notazizelse/Orbita26/project_report (1).pdf

### The report for this stage must include the following information:

1 . | Team Name | Team "BioBox" The name reflects our core idea: a simple, smart container for biological experiments in space.
2 . | Team Composition and Roles | • Alex (Team Leader & Engineer): Responsible for the mechanical design of the sealed capsule and 3D modeling. • Maria (Biologist): Responsible for choosing the biological samples and preparing the experiment conditions. • Ivan (Electronics Specialist): Responsible for sensors, temperature control, and the heating system.
3 . | Mission Objective of Your Spacecraft | Core Purpose: To test a low-cost, unified stratospheric capsule that can keep living biological samples safe by maintaining stable internal pressure and Earth-like temperature. Proposed Experiment: We plan to launch micro-greens or bacteria samples into the stratosphere. The goal is to check if our smart enclosure can completely shield them from freezing temperatures (down to -70°C) and near-vacuum conditions.
