notazizelse/Orbita26/ClearView — presentation (EN).pdf

Orbita International Space Tournament
- 2026

# ClearView

## A spacesuit visor wiper with a self-cleaning edge

### International House Tashkent Lyceum

Lola Anvarjonovna Sultonova, Grade 11

Supervisor: Ezoza Nodirjon qizi Yuldosheva

Section 2 · Crewed Spaceflight · Tashkent Visualization of the model, not a photo

Apollo 17 · December 1972

# “I think dust is probably one of

# the greatest inhibitors to a

nominal operation on the Moon.

### Gene Cernan, commander of Apollo 17

Post-flight technical debriefing, 1973 | Cernan in the lunar module after a moonwalk: the suit is grey with dust. Photo: NASA
ClearView · Lola Sultonova · Section 2 | 02 / 13

The problem

# Lunar dust vs. the visor

Fine | finer than a human hair, it gets into every gap
Sharp | the Moon has no wind or water, so the grains never get rounded like sand
Charged | sunlight charges the dust, and it clings to surfaces

Apollo 17: the astronauts kept wiping dust off their visors. Artemis is sending people back to the Moon, and the dust is still there.

Earth sand: rounded | Lunar dust: sharp

Particle shapes under magnification. The sharp edges are what scratch the visor.

Existing solutions

# What has been tried

## Apollo brushes

used on the Moon

+ simple, no electronics

− scratch the visor and clog with dust

## NASA brush study

lab tests, 2011

+ the best brushes removed over 90% of the dust

− tested on radiator surfaces, not visors

## NASA dust shield

electrodynamic

+ an electric field pushes dust off without touching

− complex electronics, high voltage

The gap I could not find a comparison of wiper materials made for a visor, judged by transparency and scratches

Goal and hypothesis

# What I want to test

## Goal

### Find out on a model whether an edge that cleans itself keeps the visor clear over many wipes without damaging it, and pick

the best of three materials.

## Hypothesis

### An edge that gets scraped clean keeps the visor clear longer than one that does not, and soft silicone scratches

less than a stiff brush.

01

Study the dust problem and what has been tried

02

Design and 3D-print a model with two scraper-troughs

03

Test 6 variants, 18 runs in total

04

Compare the results and
recommend a material

The ClearView idea

# The edge cleans itself

A plain wiper edge clogs and smears the dust back. Here the edge gets cleaned in every cycle.

## 1 · Wipe

The edge pushes the dust across the plate.

## 2 · Scrape

It passes over a rubber strip, and the dust drops into the trough.

## 3 · Back again

The return stroke starts clean. The rest goes into the second trough.

The model

# What it is made of

1 · Tilted panel, set at 45°

2 · Acrylic plate 150×100 mm stands in for the visor

3 · MG996R servo behind the panel swings the arm ±42°

4 · Arm and holder for a brush, microfibre or silicone strip

5 · Two scraper-troughs clean the edge and catch the dust

6 · Arch over the plate

7 · BH1750 light sensor in a black housing; an LED shines from behind the panel

8 · Side supports and base

9 · Arduino Nano case

14 parts printed in PLA. The picture is a render of the print files.

Measurement

# Measuring transparency

# T = E ÷ E₀ × 100%

E is the light reaching the sensor now

E₀ is the light with a clean plate

100%

clean plate

0%

sensor covered

BH1750 sensor in a
black housing

Acrylic plate with dust

LED behind the panel

Arduino

%

Method

# How the experiment runs

Edge material | With scraper | Without scraper
Stiff brush | 3 runs | 3 runs
Microfibre | 3 runs | 3 runs
Soft silicone | 3 runs | 3 runs

6 variants × 3 runs = 18 runs. Results are averaged.

≈20 cm

45°

sieve

≈1 g of gabbro-diabase
dust per run

Readings after 1, 5, 10,
20 strokes

Dust from both troughs
weighed to 0.01 g

50 strokes for the
scratch test

Work in progress

# Progress

## Done

All 14 parts designed; every screw hole and the light path checked on the computer before printing

All 3D parts printed

Dust simulant chosen: crushed gabbro-diabase

All electronics bought: Arduino Nano, MG996R servo, BH1750 sensor, two 18650 cells with a 6 V step-down

## Next

Assemble the model

Write the Arduino code and calibrate
the sensor
Run the 18 tests and fill in the results | The printed parts, rendered from the print files

One of the printed parts: the material holder

What I will measure

# Expected results

100%

75%

50%

25%

0%
0 | 1 | 5 | 10 | 20

### The tests start once the model is assembled

## Three questions

How fast does transparency drop without the scraper?

How much does the scraper slow that down?

Which material keeps the plate
clear longest?

Solid line: with scraper. Dashed: without. Horizontal axis: number of strokes.

What the model can't show

# Limits and next steps

## Limits

Earth gravity, six times the Moon's

Air, not vacuum

Gabbro-diabase dust carries no electric charge

The plate is flat

## Next steps

A curved edge for a real helmet

A button on the glove

Pair it with NASA's dust shield

axis through the
helmet's centre

edge follows
the helmet

A helmet is part of a sphere. A curved edge turning around an axis through its centre stays pressed to the visor in every position.

# Thank you!

## Happy to take your questions

Sources

1. NASA: Scientists Developing Ways to Mitigate Dust Problem for Explorers
2. Acta Astronautica: Flexible electrodynamic dust shields for lunar missions, 2026
3. Gaier et al., Evaluation of Brushing as a Lunar Dust Mitigation Strategy, NASA, 2011
4. Kobrick et al., Three-Body Abrasion Testing Using Lunar Dust Simulants, NASA, 2010
5. Schrader et al., Modal Analyses of Lunar Regolith Simulants incl. MLS-1, NASA JSC, 2008
6. Apollo 17 Technical Crew Debriefing, NASA, 1973; quoted in Levine (ed.), The Impact of Lunar Dust on Human Exploration

[QR code: video of the
model working]

lolasultonova2008@gmail.com
