notazizelse/Orbita26/hardware/SnailPulse_revC_heartbeat_only.png

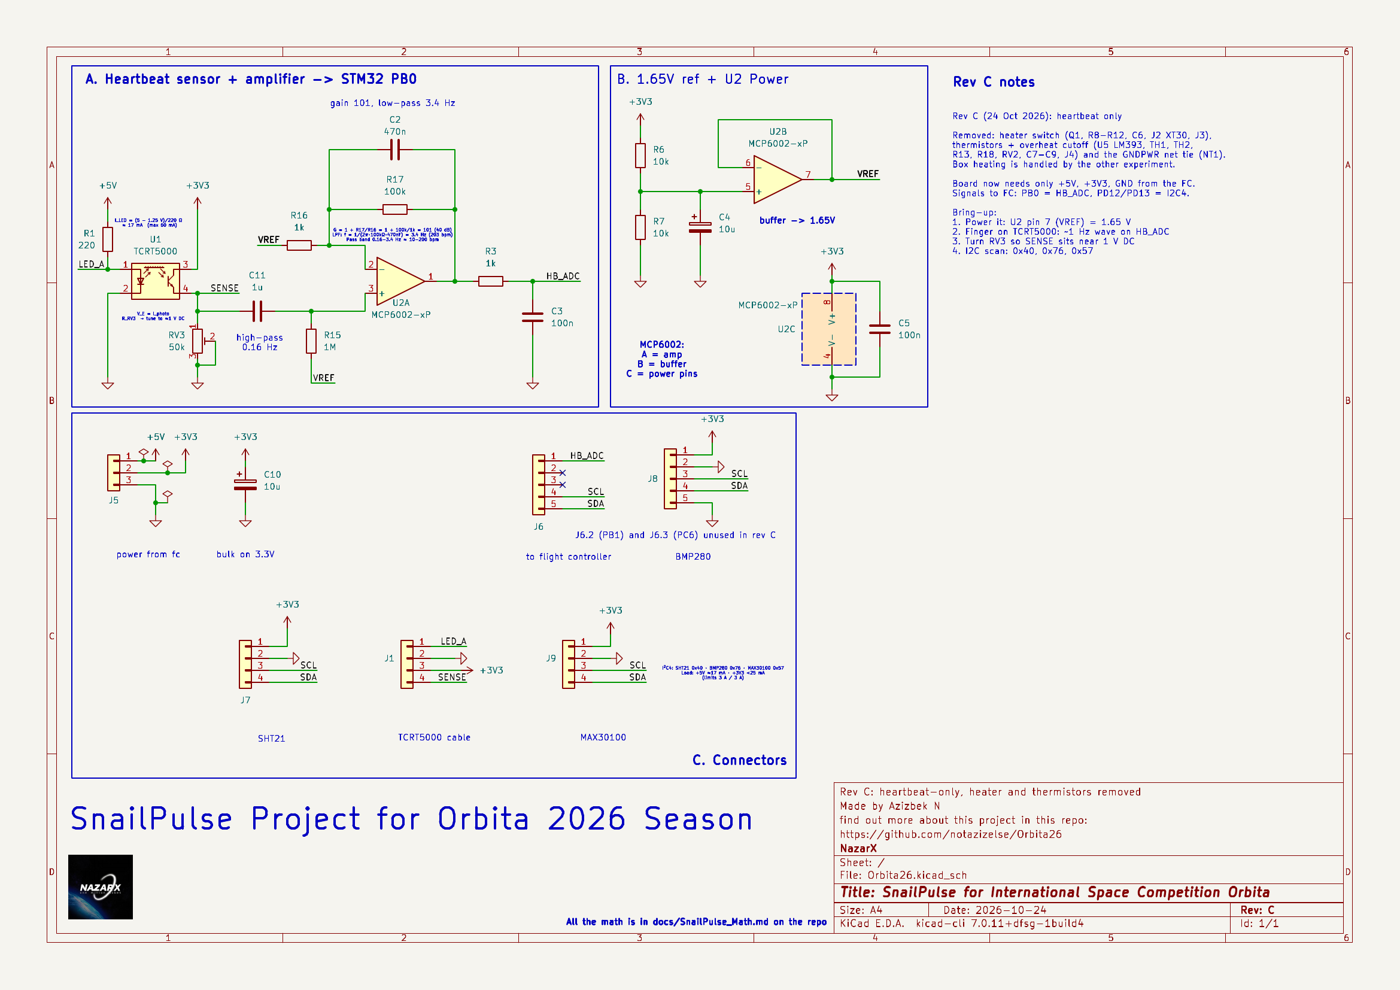
hardware/SnailPulse_revC_heartbeat_only.png
