notazizelse/Orbita26/micoair_lr900_915mhz_500mw_radio_telemetry_with_30km_range_5_550x550.jpeg

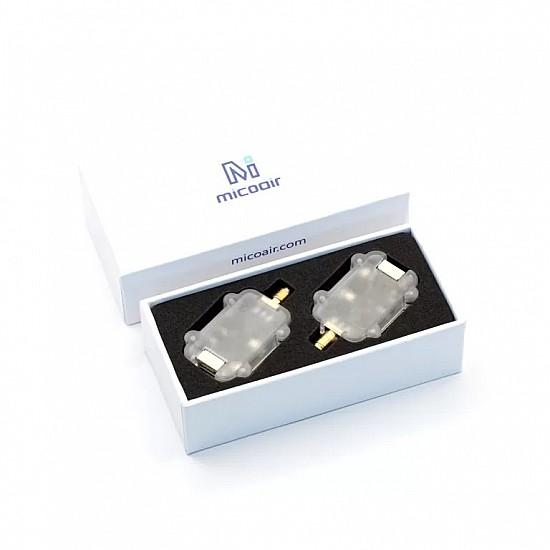
micoair_lr900_915mhz_500mw_radio_telemetry_with_30km_range_5_550x550.jpeg
