notazizelse/Orbita26/hardware/SnailPulse_shopping_list.md

# SnailPulse — список покупок, Microelectronica (electron.uz)
Цены с сайта electron.uz, 19.10.2026 ("0 сум" на сайте = уточнить у продавца).

| # | Название на сайте | Кол-во | Цена/шт | Зачем |
|---|---|---|---|---|
| 1 | FZ0225 / HW-511 Модуль датчика отслеживания линии (TCRT5000) | 2 | 8 000–13 600 | ИК-датчик сердцебиения (выпаять TCRT5000) |
| 2 | Оксиметр пульса MAX30100 | 1 | 20 000 | Запасной датчик пульса (I2C) |
| 3 | MCP6002 DIP8 | 2 | 6 800 | Усилитель + опорное 1.65 В |
| 4 | LM393N DIP8 | 2 | 3 400 | Аппаратная защита от перегрева |
| 5 | SCS-8 Dip 8pin панелька | 4 | 500 | Панельки под микросхемы |
| 6 | GY-21 SHT21 датчик влажности и температуры | 1 | 20 000 | Температура/влажность в боксе |
| 7 | Барометр BMP280 | 1 | 10 000 | Давление в боксе |
| 8 | IRLZ44N TO220 | 2 | 15 000 | Ключ нагревателя |
| 9 | 150om — 5W | 4 | ~2 000 | Нагреватель (3 шт параллельно = 50 Ом) |
| 10 | Терморезистор NTC MF58 10K | 4 | 1 000 | Температура нагревателя + защита |
| 11 | 3296W подстроечный 50KOM / 10KOM | 2 + 2 | 2 000 | Нагрузка датчика / порог защиты |
| 12 | Набор резисторов 0,25Вт 300 шт, 30 значений | 1 | 20 000 | Все резисторы (проверить 1 МОм) |
| 13 | Конденсаторы: 105-50V (1 мкФ) ×6, 474-50V (470 нФ) ×4, 104 ×10, 10mf-50V ×5 | — | 200–1 000 | Фильтры и развязка |
| 14 | 9×15 Монтажная плата 1-сторонняя | 2 | 10 000 | Плата (обрезать до 76×76 мм) |
| 15 | Набор разъёмов XH2.54 80 шт | 1 | 27 000 | Разъёмы с защёлкой |
| 16 | Клемма KF2EDG 5,08 мм (2pin ×3, 4pin ×2) | 5 | 1 000–3 000 | Питание и нагреватель |
| 17 | XT30 разъём | 1 | 5 000 | Питание 14.8 В от X8 |
| 18 | 3239 24AWG 10 м провод силиконовый | 1 | 15 000 | Монтажный провод |
| 19 | 2м кабель телефонной линии (4 жилы) | 1 | 4 000 | Кабель к датчику на раковине |
| 20 | Кембрик / термоусадка набор 100 шт | 1 | 28 000 | Изоляция |
| 21 | Каптоновый скотч 10 мм | 1 | 15 000 | Крепление NTC и проводов |
| 22 | ЦапонЛак 30 мл | 1 | 14 000 | Защита платы от конденсата |

Итого ≈ 310 000 сум.
