notazizelse/Orbita26/SnailPulse_BOM.xlsx

Orbita SnailPulse — parts list (Microelectronica, electron.uz)
Prices from electron.uz on 21 Oct 2026. Spares added for critical parts. Show the 'Name on site' column at the counter.
# | Part | Name on site | Used for | Qty | Spares | Total qty | Price each (UZS) | Line total (UZS) | Link | Note
1 | TCRT5000 sensor module (HW-511) | FZ0225 / HW-511 Модуль датчика отслеживания линии | Heartbeat sensor (desolder TCRT5000) | 1 | 2 | 3 | 8000 | 24000 | Open (https://electron.uz/product/fz0225-модуль-датчика-отслеживания-линии/)
2 | MAX30100 pulse sensor | Оксиметр пульса GY-30100 MAX30100 | Backup heartbeat sensor (I2C) | 1 | 1 | 2 | 20000 | 40000 | Open (https://electron.uz/product/оксиметр-пульса-gy-30100-max30100/)
3 | MCP6002 op-amp | MCP6002 DIP8 | Amplifier + 1.65 V reference | 1 | 2 | 3 | 6800 | 20400 | Open (https://electron.uz/product/mcp6002-dip8/)
4 | LM393N comparator | LM393N DIP8 | Hardware overheat cutoff | 1 | 2 | 3 | 3400 | 10200 | Open (https://electron.uz/product/lm393n-dip8/)
5 | DIP-8 socket | SCS-8 Dip 8pin панельки под микросхемы | Sockets so chips can be swapped | 2 | 2 | 4 | 500 | 2000 | Open (https://electron.uz/product/scs-8-dip-8pin-панельки-под-микросхемы/)
6 | SHT21 temp/humidity module | GY-21 SHT21 цифровой модуль датчика влажности и температуры | Box temperature + humidity | 1 | 1 | 2 | 20000 | 40000 | Open (https://electron.uz/product/gy-21-sht21-цифровой-модуль-датчика-влажности/)
7 | BMP280 pressure module | Барометр BMP280 (датчик атмосферного давления) | Box pressure | 1 | 1 | 2 | 10000 | 20000 | Open (https://electron.uz/product/барометр-bmp280-датчик-атмосферного-давле/)
8 | IRLZ44N MOSFET | IRLZ44N TO220 | Heater switch | 1 | 2 | 3 | 15000 | 45000 | Open (https://electron.uz/product/irlz44/)
9 | 150 Ω 5 W resistor | 150om — 5W | Heater (3 in parallel = 50 Ω) | 3 | 2 | 5 | 2065 | 10325 | Open (https://electron.uz/product/150om-5w/)
10 | NTC 10k thermistor | Терморезистор NTC MF58 10K | Heater temp + cutoff sensing | 2 | 2 | 4 | 1000 | 4000 | Open (https://electron.uz/product/терморезистор-ntc-mf58-10k/)
11 | Trimpot 50k (3296W) | 50KOM 3296W-1-503LF | Sensor load adjust | 1 | 1 | 2 | 2000 | 4000 | Open (https://electron.uz/product/50kom-3296w-1-503lf/)
12 | Trimpot 10k (3296W) | 10KOM 3296W-1-103LF | Cutoff threshold adjust | 1 | 1 | 2 | 2000 | 4000 | Open (https://electron.uz/product/10kom-3296w-1-103lf/)
13 | XT30 connector | XT30 Разъем | 14.8 V power from X8 | 1 | 1 | 2 | 5000 | 10000 | Open (https://electron.uz/product/xt30-разъем-2/)
14 | Resistor kit 0.25 W | Набор резисторов 0,25Вт 300 шт, 30 значений | All small resistors | 1 | 0 | 1 | 20000 | 20000 | Open (https://electron.uz/product/набор-резисторов-025вт-300-шт30-значений/) | Check it has 1 MΩ
15 | Ceramic cap 1 µF (105) | 105-50V (1mf) ceramic | High-pass filter | 6 | 0 | 6 | 500 | 3000 | Open (https://electron.uz/product/105-50v-1mf-ceramic/)
16 | Ceramic cap 470 nF (474) | 474-50V (470nf) ceramic | Low-pass across 100k | 4 | 0 | 4 | 500 | 2000 | Open (https://electron.uz/product/474-50v-470nf-ceramic/)
17 | Ceramic cap 100 nF (104) | 104-50V ceramicDisk | Decoupling | 10 | 0 | 10 | 500 | 5000 | Open (https://electron.uz/product/104-50v-ceramicdisk/)
18 | Electrolytic 10 µF 50 V | 10MF-50V 5×11,5 | Bulk decoupling | 5 | 0 | 5 | 1000 | 5000 | Open (https://electron.uz/product/10mf-50v-5x115/) | Site shows 0 UZS — price is an estimate, ask at counter
19 | Perfboard 9×15 cm | 9×15 Монтажная плата зел 1стороняя | Main board (cut to 76×76 mm) | 1 | 1 | 2 | 10000 | 20000 | Open (https://electron.uz/product/9x15-монтажная-плата-зел-1стороняя/)
20 | XH2.54 connector kit | Набор Разъемов XH2.54 80шт | Locking connectors | 1 | 0 | 1 | 27000 | 27000 | Open (https://electron.uz/product/набор-разъемов-xh2-54-80шт2p-3p-4p-5p-2-54мм-папа-мама/)
21 | Terminal block 2-pin | Клемма KF2EDG-2pin 5,08mm пара | Power / heater | 3 | 0 | 3 | 1000 | 3000 | Open (https://electron.uz/product/клемма-kf2edg-2pin-508mm-пара/)
22 | Terminal block 4-pin | Клемма KF2EDG-4pin 5,08mm пара | Power / heater | 2 | 0 | 2 | 3000 | 6000 | Open (https://electron.uz/product/клемма-kf2edg-4pin-508mm-пара/)
23 | Silicone wire 24AWG 10 m | 3239 24AWG (0,21мм²) 10метр провод силиконовый | Board wiring | 1 | 0 | 1 | 15000 | 15000 | Open (https://electron.uz/product/3239-24awg021mm2-10метр-провод-монтажный-силиконовы/)
24 | Phone cable 2 m (4-core) | 2м Кабель телефонной линии | Cable to sensor on the shell | 1 | 0 | 1 | 4000 | 4000 | Open (https://electron.uz/product/2м-кабель-телефонной-линии/)
25 | Heat-shrink kit 100 pcs | Кембрик термоусадка набор XCL 100шт Ø2-7мм | Insulation | 1 | 0 | 1 | 30000 | 30000 | Open (https://electron.uz/product/кембрик-термоусадка-набор-ncl-100шт-компле/)
26 | Kapton tape 10 mm | 10mm x30m каптоновый скотч | Holding NTCs and wires | 1 | 0 | 1 | 15000 | 15000 | Open (https://electron.uz/product/10mm-x30m-каптоновый-скотч-термостойкий-высо/)
27 | Conformal varnish 30 ml | ЦапонЛак 30мл | Coats board against condensation | 1 | 0 | 1 | 14000 | 14000 | Open (https://electron.uz/product/цапонлак-30мл-безцветный/)
 | TOTAL |  |  |  |  | 76 |  | 402925 UZS
 | of which spares |  |  |  |  |  |  | 142530 UZS
 | Yellow rows = critical parts with spares. Blue numbers are inputs you can change; totals update.
