notazizelse/Orbita26/budget/SnailPulse_BOM_v2.xlsx

Orbita SnailPulse — parts list (Microelectronica, electron.uz)
Green rows = added after checking against the schematic · orange = quantity changed
Component name | Part number | Specific details | Link | Picture | Qty | Spares | Total qty | Price each (UZS) | Line total (UZS) | Name on site (show at counter) | Note
Active components (ICs, transistors) |  | Electronic components counter · +998 95 199-04-61
Op-amp, dual | MCP6002-I/P | DIP-8 · rail-to-rail in/out · 1.8–6 V · 1 MHz | Open (https://electron.uz/product/mcp6002-dip8/) |  | 1 | 1 |  | 6800 |  | MCP6002 DIP8 | U2 — amplifier + 1.65 V buffer
Comparator, dual | LM393N | DIP-8 · open-collector output · 2–36 V supply | Open (https://electron.uz/product/lm393n-dip8/) |  | 1 | 1 |  | 3400 |  | LM393N DIP8 | U5 — hardware 40 °C heater cutoff
MOSFET, N-channel logic-level | IRLZ44N | TO-220 · 55 V · 47 A · 22 mΩ at Vgs 5 V | Open (https://electron.uz/product/irlz44/) | no photo on site | 1 | 1 |  | 15000 |  | IRLZ44N TO220 | Q1 — heater switch
IC socket | SCS-8 | DIP-8 · 2.54 mm pitch | Open (https://electron.uz/product/scs-8-dip-8pin-%D0%BF%D0%B0%D0%BD%D0%B5%D0%BB%D1%8C%D0%BA%D0%B8-%D0%BF%D0%BE%D0%B4-%D0%BC%D0%B8%D0%BA%D1%80%D0%BE%D1%81%D1%85%D0%B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) |  | 2 | 2 |  | 500 |  | SCS-8 Dip 8pin панельки | For U2 and U5
 |  |  |  |  |  |  |  | Subtotal
Passive components |  | Electronic components counter · +998 95 199-04-61
Resistor kit | CF 0.25 W kit, 300 pcs | 30 values × 10 pcs · 0.25 W · ±5 % · THT | Open (https://electron.uz/product/%D0%BD%D0%B0%D0%B1%D0%BE%D1%80-%D1%80%D0%B5%D0%B7%D0%B8%D1%81%D1%82%D0%BE%D1%80%D0%BE%D0%B2-025%D0%B2%D1%82-300-%D1%88%D1%8230-%D0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) |  | 1 | 0 |  | 20000 |  | Набор резисторов 0,25Вт 300 шт | Needs 220 Ω ×1, 1 k ×3, 10 k ×5, 100 k ×1, 1 MΩ ×1 — check 220 Ω and 1 MΩ are in the kit
Power resistor (heater) | 150 Ω 5 W | 5 W · ±5 % · ceramic/cement · axial | Open (https://electron.uz/product/150om-5w/) |  | 3 | 2 |  | 2065 |  | 150om — 5W | R8–R10, 3 in parallel = 50 Ω
NTC thermistor | MF58 10K | 10 kΩ at 25 °C · B ≈ 3950 · glass, axial | Open (https://electron.uz/product/%D1%82%D0%B5%D1%80%D0%BC%D0%BE%D1%80%D0%B5%D0%B7%D0%B8%D1%81%D1%82%D0%BE%D1%80-ntc-mf58-10k/) |  | 2 | 2 |  | 1000 |  | Терморезистор NTC MF58 10K | TH1 (firmware), TH2 (cutoff)
Trimpot 50 kΩ | 3296W-1-503LF | 50 kΩ · 25-turn · top adjust · THT | Open (https://electron.uz/product/50kom-3296w-1-503lf/) |  | 1 | 1 |  | 2000 |  | 50KOM 3296W-1-503LF | RV3 — sensor load
Trimpot 10 kΩ | 3296W-1-103LF | 10 kΩ · 25-turn · top adjust · THT | Open (https://electron.uz/product/10kom-3296w-1-103lf/) |  | 1 | 1 |  | 2000 |  | 10KOM 3296W-1-103LF | RV2 — cutoff threshold
Ceramic capacitor 1 µF | 105 | 1 µF · 50 V · multilayer ceramic · THT | Open (https://electron.uz/product/105-50v-1mf-ceramic/) | no photo on site | 1 | 2 |  | 500 |  | 105-50V (1mf) ceramic | C11 — only 1 needed (was 6)
Ceramic capacitor 470 nF | 474 | 470 nF · 50 V · multilayer ceramic · THT | Open (https://electron.uz/product/474-50v-470nf-ceramic/) | no photo on site | 1 | 2 |  | 500 |  | 474-50V (470nf) ceramic | C2 — only 1 needed (was 4)
Ceramic capacitor 100 nF | 104 | 100 nF · 50 V · ceramic disc · THT | Open (https://electron.uz/product/104-50v-ceramicdisk/) | no photo on site | 5 | 5 |  | 500 |  | 104-50V ceramicDisk | C3, C5, C7, C8, C9
Electrolytic capacitor 10 µF | 10 µF 50 V | 10 µF · 50 V · radial · 5 × 11.5 mm | Open (https://electron.uz/product/10mf-50v-5x115/) |  | 3 | 2 |  | 1000 |  | 10MF-50V 5×11,5 | C4, C6, C10 · site shows 0 UZS, price is an estimate
 |  |  |  |  |  |  |  | Subtotal
Modules & sensors |  | Arduino / modules counter · +998 95 196-04-61
IR reflective sensor module | HW-511 / FZ0225 (TCRT5000) | IR LED + phototransistor · desolder the TCRT5000 | Open (https://electron.uz/product/fz0225-%D0%BC%D0%BE%D0%B4%D1%83%D0%BB%D1%8C-%D0%B4%D0%B0%D1%82%D1%87%D0%B8%D0%BA%D0%B0-%D0%BE%D1%82%D1%81%D0%BB%D0%B5%D0%B6%D0%B8%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) |  | 1 | 1 |  | 8000 |  | FZ0225 / HW-511 Модуль датчика отслеживания линии | U1 — heartbeat sensor
Pulse oximeter module | GY-MAX30100 | I²C 0x57 · 3.3 V · backup heartbeat sensor | Open (https://electron.uz/product/%D0%BE%D0%BA%D1%81%D0%B8%D0%BC%D0%B5%D1%82%D1%80-%D0%BF%D1%83%D0%BB%D1%8C%D1%81%D0%B0-gy-30100-max30100/) |  | 1 | 0 |  | 20000 |  | Оксиметр пульса GY-30100 MAX30100 | J9 · cheap boards pull I²C up to 1.8 V — cut the pull-ups
Temperature + humidity module | GY-21 (SHT21) | I²C 0x40 · 3.3 V | Open (https://electron.uz/product/gy-21-sht21-%D1%86%D0%B8%D1%84%D1%80%D0%BE%D0%B2%D0%BE%D0%B9-%D0%BC%D0%BE%D0%B4%D1%83%D0%BB%D1%8C-%D0%B4%D0%B0%D1%82%D1%87%D0%B8%D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) |  | 1 | 0 |  | 20000 |  | GY-21 SHT21 датчик влажности и температуры | J7
Pressure module | GY-BMP280 | I²C 0x76 (SDO → GND) · 3.3 V | Open (https://electron.uz/product/%D0%B1%D0%B0%D1%80%D0%BE%D0%BC%D0%B5%D1%82%D1%80-bmp280-%D0%B4%D0%B0%D1%82%D1%87%D0%B8%D0%BA-%D0%B0%D1%82%D0%BC%D0%BE%D1%81%D1%84%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) |  | 1 | 0 |  | 10000 |  | Барометр BMP280 | J8 · store photo shows a BME280 board
 |  |  |  |  |  |  |  | Subtotal
Connectors, board & wire |  | Ask either counter
Power connector | XT30 | 30 A · 2-pin · for 14.8 V from X8 | Open (https://electron.uz/product/xt30-%D1%80%D0%B0%D0%B7%D1%8A%D0%B5%D0%BC-2/) |  | 1 | 1 |  | 5000 |  | XT30 Разъем | J2
Terminal block 2-pin | KF2EDG-2P | 5.08 mm pitch · pluggable · sold as a pair | Open (https://electron.uz/product/%D0%BA%D0%BB%D0%B5%D0%BC%D0%BC%D0%B0-kf2edg-2pin-508mm-%D0%BF%D0%B0%D1%80%D0%B0/) |  | 1 | 1 |  | 1000 |  | Клемма KF2EDG-2pin 5,08mm пара | J3 heater output — the only terminal block left in the schematic (was 3)
JST-XH connector kit | XH2.54, 80 pcs | 2/3/4/5-pin · male + female · 2.54 mm | Open (https://electron.uz/product/%d0%bd%d0%b0%d0%b1%d0%be%d1%80-%d1%80%d0%b0%d0%b7%d1%8a%d0%b5%d0%bc%d0%be%d0%b2-xh2-54-80%d1%88%d1%822p-3p-4p-5p-2-54%d0%bc%d0%bc-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) |  | 1 | 0 |  | 27000 |  | Набор Разъемов XH2.54 80шт, 2p 3p 4p 5p | J1, J4, J7, J9 = 4-pin · J6, J8 = 5-pin · J5 = 3-pin. Needs a crimp tool
Sensor cable, 4-core | 2 m phone line cable | RJ11 flat cable · check it is 4-core (6P4C) | Open (https://electron.uz/product/2%d0%bc-%d0%ba%d0%b0%d0%b1%d0%b5%d0%bb%d1%8c-%d1%82%d0%b5%d0%bb%d0%b5%d1%84%d0%be%d0%bd%d0%bd%d0%be%d0%b9-%d0%bb%d0%b8%d0%bd%d0%b8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) | no photo on site | 1 | 0 |  | 4000 |  | 2м Кабель телефонной линии | J1 → TCRT5000 on the shell
Silicone wire 24 AWG | 3239 24AWG, 10 m | 0.21 mm² · silicone · flexible | Open (https://electron.uz/product/3239-24awg021mm2-10%d0%bc%d0%b5%d1%82%d1%80-%d0%bf%d1%80%d0%be%d0%b2%d0%be%d0%b4-%d0%bc%d0%be%d0%bd%d1%82%d0%b0%d0%b6%d0%bd%d1%8b%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) |  | 1 | 0 |  | 15000 |  | 3239 24AWG 10метр провод силиконовый | Board wiring, module cables (J7–J9), thermistor and heater leads
Heat-shrink tube set | XCL, 100 pcs | Ø 2–7 mm · 20 cm lengths | Open (https://electron.uz/product/%d0%ba%d0%b5%d0%bc%d0%b1%d1%80%d0%b8%d0%ba-%d1%82%d0%b5%d1%80%d0%bc%d0%be%d1%83%d1%81%d0%b0%d0%b4%d0%ba%d0%b0-%d0%bd%d0%b0%d0%b1%d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) |  | 1 | 0 |  | 30000 |  | Кембрик термоусадка набор XCL 100шт 20см Ø2-7мм | Insulating sensor, thermistor and heater joints
Kapton tape 10 mm | 10 mm × 30 m | polyimide · heat-resistant | Open (https://electron.uz/product/10mm-x30m-%d0%ba%d0%b0%d0%bf%d1%82%d0%be%d0%bd%d0%be%d0%b2%d1%8b%d0%b9-%d1%81%d0%ba%d0%be%d1%82%d1%87-%d1%82%d0%b5%d1%80%d0%bc%d0%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) |  | 1 | 0 |  | 15000 |  | 10mm x30m каптоновый скотч Koptan | Holds NTCs on the heater plate, fixes wires · store photo shows the 50 mm roll
Conformal coating (Tsapon lacquer) | ЦапонЛак 30 ml | clear · brush-on | Open (https://electron.uz/?s=%D1%86%D0%B0%D0%BF%D0%BE%D0%BD%D0%BB%D0%B0%D0%BA&post_type=product) |  | 1 | 0 |  | 14000 |  | ЦапонЛак 30мл бесцветный | Protects the board from condensation in the cold · price from your 19 Oct list
Perfboard | 9 × 15 cm, single-sided | 2.54 mm pitch · cut to 76 × 76 mm | Open (https://electron.uz/product/9x15-%D0%BC%D0%BE%D0%BD%D1%82%D0%B0%D0%B6%D0%BD%D0%B0%D1%8F-%D0%BF%D0%BB%D0%B0%D1%82%D0%B0-%D0%B7%D0%B5%D0%BB-1%D1%81%D1%82%D0%BE%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) |  | 1 | 1 |  | 10000 |  | 9×15 Монтажная плата зел 1стороняя
 |  |  |  |  |  |  |  | Subtotal
 |  |  |  |  |  |  |  | TOTAL
Not in this list: solder, flux and a JST-XH crimp tool — bring from the lab. Removed vs. previous version: KF2EDG 4-pin ×2 (J5/J6 are JST-XH in the schematic).
