notazizelse/Orbita26/hardware/SnailPulse_KiCad_Connections.xlsx

Sheet: Start here
SnailPulse — KiCad schematic connection workbook
Orbita 2026 · everything you need to draw the schematic, part by part
How to use this workbook
1. Parts tab — place every symbol in KiCad (Add Symbol, A). Copy the Symbol name into the search box.
2. Wiring tab — go part by part, pin by pin. Draw what the 'Net' column says, then pick ✓ in the Done column. The row turns green.
3. Nets tab — cross-check: every net should have the pin count shown. 'Pins found' updates from the Wiring tab.
4. Connectors tab — which wire from each plug goes where off the board (cable colours too).
5. Run ERC (Inspect → Electrical Rules Checker) and fix everything before assigning footprints.
Colour key — blocks (same blocks as the drawings in chat)
A · Heartbeat amplifier
B · 1.65 V reference
C · Heater power switch
D · Temperature + overheat cutoff
E · Flight computer + sensor plugs
Colour key — net types
Power
Ground
Analog
Control
Heater
Digital I²C
KiCad tips that will save you time
• Power nets (+5V, +3V3, +14V8, GND, GNDPWR): never draw long wires — drop a power symbol at each pin. Same symbol name = same net.
• +14V8 has no built-in symbol: place power:VCC, press E, change its Value to +14V8. That renames the net.
• Add PWR_FLAG symbols on +5V, +3V3 and GND (next to J2) and on +14V8 and GNDPWR (next to J4), or ERC says 'power input not driven'.
• Signal nets: short wires inside a block; a net label (L) when the net crosses blocks (VREF, GATE, HB_ADC, NTC1_ADC, NTC2, PWM, SCL, SDA).
• MCP6002 and LM393 have 3 units each: A, B = the two halves, C = the power pins. You must place all three or ERC complains.
• U2 unit B is unused: wire pins 5 and 6 to GND and put a No-Connect flag (Q) on pin 7.
• Off-board parts (U3, TH1, TH2, R8–R10) are drawn so the circuit makes sense. In each one's properties tick 'Exclude from board'.
• NT1 (net tie) is the single point where heater ground (GNDPWR) joins signal ground (GND). On perfboard it is just one short wire.
• Match pins by NAME for U3 (A, K, C, E), Q1 (G, D, S) and the electrolytics (+ / −). Numbers can differ between symbol versions.
• JST-XH is really 2.50 mm pitch; on 2.54 mm perfboard it still fits up to 5 pins.
Changes since last night's connection map
• Off-board items now go through plugs: J1 sensor, J5 heater, J6 thermistors, J7–J9 sensor modules, J2/J3 flight computer, J4 XT30.
• Added C8 (10 µF on 3.3 V), C10 and C11 (100 nF on the two NTC lines), NT1 net tie.
• R12 gate pull-down now goes to GNDPWR (right next to Q1's source) instead of signal GND.

Sheet: Parts
Block | Ref | Value | What it does | KiCad symbol (Add Symbol → search) | Footprint | On board? | Placed
A · Heartbeat amplifier
A | U3 | TCRT5000 | IR sensor on the snail shell (LED + phototransistor) | Sensor_Proximity:TCRT5000 (if missing: Sensor_Proximity:CNY70, same pin names) | — (off-board, tick “Exclude from board”) | No — off-board
A | J1 | Conn 1×4 (JST-XH) | Plug for the sensor cable | Connector_Generic:Conn_01x04 | Connector_JST:JST_XH_B4B-XH-A_1x04_P2.50mm_Vertical | Yes
A | R1 | 220Ω | Sets IR LED current (~17 mA) | Device:R | Resistor_THT:R_Axial_DIN0207_L6.3mm_D2.5mm_P7.62mm_Horizontal | Yes
A | RV1 | 50k trim | Phototransistor load — turns light into voltage | Device:R_Potentiometer_Trim | Potentiometer_THT:Potentiometer_Bourns_3296W_Vertical | Yes
A | C1 | 1µF | High-pass: blocks the steady DC level | Device:C | Capacitor_THT:C_Disc_D5.0mm_W2.5mm_P5.00mm | Yes
A | R2 | 1M | High-pass: re-centres signal on 1.65 V | Device:R | Resistor_THT:R_Axial_DIN0207_L6.3mm_D2.5mm_P7.62mm_Horizontal | Yes
A | U1 | MCP6002 · unit A | Amplifier, gain 101 | Amplifier_Operational:MCP6002-xP (unit A) | Package_DIP:DIP-8_W7.62mm_Socket | Yes
A | R3 | 1k | Gain resistor (to VREF) | Device:R | Resistor_THT:R_Axial_DIN0207_L6.3mm_D2.5mm_P7.62mm_Horizontal | Yes
A | R4 | 100k | Feedback resistor | Device:R | Resistor_THT:R_Axial_DIN0207_L6.3mm_D2.5mm_P7.62mm_Horizontal | Yes
A | C2 | 470nF | Low-pass ~3.4 Hz (across R4) | Device:C | Capacitor_THT:C_Disc_D5.0mm_W2.5mm_P5.00mm | Yes
A | R5 | 1k | ADC input filter + pin protection | Device:R | Resistor_THT:R_Axial_DIN0207_L6.3mm_D2.5mm_P7.62mm_Horizontal | Yes
A | C3 | 100nF | ADC input filter | Device:C | Capacitor_THT:C_Disc_D5.0mm_W2.5mm_P5.00mm | Yes
B · 1.65 V reference
B | R6 | 10k | Divider top (3.3 V → 1.65 V) | Device:R | Resistor_THT:R_Axial_DIN0207_L6.3mm_D2.5mm_P7.62mm_Horizontal | Yes
B | R7 | 10k | Divider bottom | Device:R | Resistor_THT:R_Axial_DIN0207_L6.3mm_D2.5mm_P7.62mm_Horizontal | Yes
B | C4 | 10µF | Smooths the divider | Device:C_Polarized | Capacitor_THT:CP_Radial_D5.0mm_P2.00mm | Yes
B | U1 | MCP6002 · unit B | Buffer → makes VREF | Amplifier_Operational:MCP6002-xP (unit B) | Package_DIP:DIP-8_W7.62mm_Socket | Yes
B | U1 | MCP6002 · unit C (power) | Power pins of U1 | Amplifier_Operational:MCP6002-xP (unit C) | Package_DIP:DIP-8_W7.62mm_Socket | Yes
B | C5 | 100nF | Decoupling for U1 — place at pins 8–4 | Device:C | Capacitor_THT:C_Disc_D5.0mm_W2.5mm_P5.00mm | Yes
C · Heater power switch
C | J4 | XT30 | 14.8 V input from port X8 | Connector_Generic:Conn_01x02 | Connector_AMASS:AMASS_XT30U-M_1x02_P5.0mm_Vertical | Yes
C | C6 | 10µF 50V | Absorbs PWM current pulses | Device:C_Polarized | Capacitor_THT:CP_Radial_D5.0mm_P2.00mm | Yes
C | J5 | Terminal 1×2 (KF2EDG) | Heater wires out | Connector_Generic:Conn_01x02 | TerminalBlock:TerminalBlock_bornier-2_P5.08mm | Yes
C | R8 | 150Ω 5W | Heater element (3 in parallel = 50 Ω) | Device:R | — (off-board, tick “Exclude from board”) | No — off-board
C | R9 | 150Ω 5W | Heater element (3 in parallel = 50 Ω) | Device:R | — (off-board, tick “Exclude from board”) | No — off-board
C | R10 | 150Ω 5W | Heater element (3 in parallel = 50 Ω) | Device:R | — (off-board, tick “Exclude from board”) | No — off-board
C | Q1 | IRLZ44N | Switches heater on/off | Transistor_FET:IRLZ44N | Package_TO_SOT_THT:TO-220-3_Vertical | Yes
C | R11 | 1k | Gate resistor — lets U2 overpower PC6 | Device:R | Resistor_THT:R_Axial_DIN0207_L6.3mm_D2.5mm_P7.62mm_Horizontal | Yes
C | R12 | 10k | Gate pull-down — heater OFF during boot | Device:R | Resistor_THT:R_Axial_DIN0207_L6.3mm_D2.5mm_P7.62mm_Horizontal | Yes
C | NT1 | Net tie | The ONE point where power ground meets signal ground | Device:NetTie_2 | NetTie:NetTie-2_THT_Pad1.0mm | Yes
D · Temperature + overheat cutoff
D | J6 | Conn 1×4 (JST-XH) | Plug for the two thermistors | Connector_Generic:Conn_01x04 | Connector_JST:JST_XH_B4B-XH-A_1x04_P2.50mm_Vertical | Yes
D | TH1 | NTC 10k | Heater temp → firmware (PB1) | Device:Thermistor_NTC | — (off-board, tick “Exclude from board”) | No — off-board
D | R14 | 10k | Divider with TH1 | Device:R | Resistor_THT:R_Axial_DIN0207_L6.3mm_D2.5mm_P7.62mm_Horizontal | Yes
D | C10 | 100nF | Filters NTC1 reading | Device:C | Capacitor_THT:C_Disc_D5.0mm_W2.5mm_P5.00mm | Yes
D | TH2 | NTC 10k | Heater temp → hardware cutoff | Device:Thermistor_NTC | — (off-board, tick “Exclude from board”) | No — off-board
D | R13 | 10k | Divider with TH2 | Device:R | Resistor_THT:R_Axial_DIN0207_L6.3mm_D2.5mm_P7.62mm_Horizontal | Yes
D | C11 | 100nF | Filters NTC2 (stops comparator chatter) | Device:C | Capacitor_THT:C_Disc_D5.0mm_W2.5mm_P5.00mm | Yes
D | RV2 | 10k trim | Cutoff threshold — set ≈1.1 V (40 °C) | Device:R_Potentiometer_Trim | Potentiometer_THT:Potentiometer_Bourns_3296W_Vertical | Yes
D | U2 | LM393 · unit A | Comparator: too hot → pulls GATE low | Comparator:LM393 (unit A) | Package_DIP:DIP-8_W7.62mm_Socket | Yes
D | U2 | LM393 · unit B (unused) | Spare half — tie off | Comparator:LM393 (unit B) | Package_DIP:DIP-8_W7.62mm_Socket | Yes
D | U2 | LM393 · unit C (power) | Power pins of U2 — 5 V! | Comparator:LM393 (unit C) | Package_DIP:DIP-8_W7.62mm_Socket | Yes
D | C7 | 100nF | Decoupling for U2 — place at pins 8–4 | Device:C | Capacitor_THT:C_Disc_D5.0mm_W2.5mm_P5.00mm | Yes
E · Flight computer + sensor plugs
E | J2 | Conn 1×3 (JST-XH) | Power from flight computer | Connector_Generic:Conn_01x03 | Connector_JST:JST_XH_B3B-XH-A_1x03_P2.50mm_Vertical | Yes
E | C8 | 10µF | Bulk cap on 3.3 V | Device:C_Polarized | Capacitor_THT:CP_Radial_D5.0mm_P2.00mm | Yes
E | J3 | Conn 1×5 (JST-XH) | Signals to flight computer | Connector_Generic:Conn_01x05 | Connector_JST:JST_XH_B5B-XH-A_1x05_P2.50mm_Vertical | Yes
E | J7 | Conn 1×4 (JST-XH) | SHT21 module plug | Connector_Generic:Conn_01x04 | Connector_JST:JST_XH_B4B-XH-A_1x04_P2.50mm_Vertical | Yes
E | J8 | Conn 1×5 (JST-XH) | BMP280 module plug (pin 5 = SDO → GND, address 0x76) | Connector_Generic:Conn_01x05 | Connector_JST:JST_XH_B5B-XH-A_1x05_P2.50mm_Vertical | Yes
E | J9 | Conn 1×4 (JST-XH) | MAX30100 module plug | Connector_Generic:Conn_01x04 | Connector_JST:JST_XH_B4B-XH-A_1x04_P2.50mm_Vertical | Yes

Sheet: Wiring
Pin-by-pin wiring — draw each row, then pick ✓
Progress: 0 of 116 pins drawn |  |  |  | 0%
Block | Ref | Part | Pin # | Pin name | Net | Connects to (other pins on this net) | How to draw it in KiCad | Done
A · Heartbeat amplifier
A | U3 | TCRT5000 | A | LED anode | LED_A | J1.1, R1.2 | Wire (or label LED_A)
A | U3 | TCRT5000 | K | LED cathode | GND | Power net — 27 pins share it (see Nets tab) | power:GND symbol
A | U3 | TCRT5000 | C | Collector | +3V3 | Power net — 13 pins share it (see Nets tab) | power:+3V3 symbol
A | U3 | TCRT5000 | E | Emitter | SENSE | J1.4, RV1.1, C1.1 | Wire (or label SENSE)
A | J1 | Conn 1×4 (JST-XH) | 1 | Pin_1 | LED_A | U3.A, R1.2 | Wire (or label LED_A)
A | J1 | Conn 1×4 (JST-XH) | 2 | Pin_2 | GND | Power net — 27 pins share it (see Nets tab) | power:GND symbol
A | J1 | Conn 1×4 (JST-XH) | 3 | Pin_3 | +3V3 | Power net — 13 pins share it (see Nets tab) | power:+3V3 symbol
A | J1 | Conn 1×4 (JST-XH) | 4 | Pin_4 | SENSE | U3.E, RV1.1, C1.1 | Wire (or label SENSE)
A | R1 | 220Ω | 1 | ~ | +5V | Power net — 4 pins share it (see Nets tab) | power:+5V symbol
A | R1 | 220Ω | 2 | ~ | LED_A | U3.A, J1.1 | Wire (or label LED_A)
A | RV1 | 50k trim | 1 | 1 | SENSE | U3.E, J1.4, C1.1 | Wire (or label SENSE)
A | RV1 | 50k trim | 2 | wiper | GND | Power net — 27 pins share it (see Nets tab) | power:GND symbol
A | RV1 | 50k trim | 3 | 3 | GND | Power net — 27 pins share it (see Nets tab) | power:GND symbol
A | C1 | 1µF | 1 | ~ | SENSE | U3.E, J1.4, RV1.1 | Wire (or label SENSE)
A | C1 | 1µF | 2 | ~ | HP_IN | R2.1, U1.3 | Wire (or label HP_IN)
A | R2 | 1M | 1 | ~ | HP_IN | C1.2, U1.3 | Wire (or label HP_IN)
A | R2 | 1M | 2 | ~ | VREF | R3.2, U1.6, U1.7 | Label VREF (used in 2 blocks)
A | U1 | MCP6002 · unit A | 3 | + | HP_IN | C1.2, R2.1 | Wire (or label HP_IN)
A | U1 | MCP6002 · unit A | 2 | − | FB | R3.1, R4.1, C2.1 | Wire (or label FB)
A | U1 | MCP6002 · unit A | 1 | OUT | AMP_OUT | R4.2, C2.2, R5.1 | Wire (or label AMP_OUT)
A | R3 | 1k | 1 | ~ | FB | U1.2, R4.1, C2.1 | Wire (or label FB)
A | R3 | 1k | 2 | ~ | VREF | R2.2, U1.6, U1.7 | Label VREF (used in 2 blocks)
A | R4 | 100k | 1 | ~ | FB | U1.2, R3.1, C2.1 | Wire (or label FB)
A | R4 | 100k | 2 | ~ | AMP_OUT | U1.1, C2.2, R5.1 | Wire (or label AMP_OUT)
A | C2 | 470nF | 1 | ~ | FB | U1.2, R3.1, R4.1 | Wire (or label FB)
A | C2 | 470nF | 2 | ~ | AMP_OUT | U1.1, R4.2, R5.1 | Wire (or label AMP_OUT)
A | R5 | 1k | 1 | ~ | AMP_OUT | U1.1, R4.2, C2.2 | Wire (or label AMP_OUT)
A | R5 | 1k | 2 | ~ | HB_ADC | C3.1, J3.1 | Label HB_ADC
A | C3 | 100nF | 1 | ~ | HB_ADC | R5.2, J3.1 | Label HB_ADC
A | C3 | 100nF | 2 | ~ | GND | Power net — 27 pins share it (see Nets tab) | power:GND symbol
B · 1.65 V reference
B | R6 | 10k | 1 | ~ | +3V3 | Power net — 13 pins share it (see Nets tab) | power:+3V3 symbol
B | R6 | 10k | 2 | ~ | REF_DIV | R7.1, C4.1, U1.5 | Wire (or label REF_DIV)
B | R7 | 10k | 1 | ~ | REF_DIV | R6.2, C4.1, U1.5 | Wire (or label REF_DIV)
B | R7 | 10k | 2 | ~ | GND | Power net — 27 pins share it (see Nets tab) | power:GND symbol
B | C4 | 10µF | 1 | + | REF_DIV | R6.2, R7.1, U1.5 | Wire (or label REF_DIV)
B | C4 | 10µF | 2 | − | GND | Power net — 27 pins share it (see Nets tab) | power:GND symbol
B | U1 | MCP6002 · unit B | 5 | + | REF_DIV | R6.2, R7.1, C4.1 | Wire (or label REF_DIV)
B | U1 | MCP6002 · unit B | 6 | − | VREF | R2.2, R3.2, U1.7 | Label VREF (used in 2 blocks)
B | U1 | MCP6002 · unit B | 7 | OUT | VREF | R2.2, R3.2, U1.6 | Label VREF (used in 2 blocks)
B | U1 | MCP6002 · unit C (power) | 8 | V+ | +3V3 | Power net — 13 pins share it (see Nets tab) | power:+3V3 symbol
B | U1 | MCP6002 · unit C (power) | 4 | V− | GND | Power net — 27 pins share it (see Nets tab) | power:GND symbol
B | C5 | 100nF | 1 | ~ | +3V3 | Power net — 13 pins share it (see Nets tab) | power:+3V3 symbol
B | C5 | 100nF | 2 | ~ | GND | Power net — 27 pins share it (see Nets tab) | power:GND symbol
C · Heater power switch
C | J4 | XT30 | 1 | + | +14V8 | Power net — 6 pins share it (see Nets tab) | power:VCC symbol, change Value to +14V8
C | J4 | XT30 | 2 | − | GNDPWR | Power net — 5 pins share it (see Nets tab) | power:GNDPWR symbol
C | C6 | 10µF 50V | 1 | + | +14V8 | Power net — 6 pins share it (see Nets tab) | power:VCC symbol, change Value to +14V8
C | C6 | 10µF 50V | 2 | − | GNDPWR | Power net — 5 pins share it (see Nets tab) | power:GNDPWR symbol
C | J5 | Terminal 1×2 (KF2EDG) | 1 | Pin_1 | +14V8 | Power net — 6 pins share it (see Nets tab) | power:VCC symbol, change Value to +14V8
C | J5 | Terminal 1×2 (KF2EDG) | 2 | Pin_2 | HEATER_LO | R8.2, R9.2, R10.2, Q1.2 | Label HEATER_LO
C | R8 | 150Ω 5W | 1 | ~ | +14V8 | Power net — 6 pins share it (see Nets tab) | power:VCC symbol, change Value to +14V8
C | R8 | 150Ω 5W | 2 | ~ | HEATER_LO | J5.2, R9.2, R10.2, Q1.2 | Label HEATER_LO
C | R9 | 150Ω 5W | 1 | ~ | +14V8 | Power net — 6 pins share it (see Nets tab) | power:VCC symbol, change Value to +14V8
C | R9 | 150Ω 5W | 2 | ~ | HEATER_LO | J5.2, R8.2, R10.2, Q1.2 | Label HEATER_LO
C | R10 | 150Ω 5W | 1 | ~ | +14V8 | Power net — 6 pins share it (see Nets tab) | power:VCC symbol, change Value to +14V8
C | R10 | 150Ω 5W | 2 | ~ | HEATER_LO | J5.2, R8.2, R9.2, Q1.2 | Label HEATER_LO
C | Q1 | IRLZ44N | 1 | G | GATE | R11.2, R12.1, U2.1 | Label GATE (used in 2 blocks)
C | Q1 | IRLZ44N | 2 | D | HEATER_LO | J5.2, R8.2, R9.2, R10.2 | Label HEATER_LO
C | Q1 | IRLZ44N | 3 | S | GNDPWR | Power net — 5 pins share it (see Nets tab) | power:GNDPWR symbol
C | R11 | 1k | 1 | ~ | PWM | J3.3 | Label PWM
C | R11 | 1k | 2 | ~ | GATE | Q1.1, R12.1, U2.1 | Label GATE (used in 2 blocks)
C | R12 | 10k | 1 | ~ | GATE | Q1.1, R11.2, U2.1 | Label GATE (used in 2 blocks)
C | R12 | 10k | 2 | ~ | GNDPWR | Power net — 5 pins share it (see Nets tab) | power:GNDPWR symbol
C | NT1 | Net tie | 1 | 1 | GNDPWR | Power net — 5 pins share it (see Nets tab) | power:GNDPWR symbol
C | NT1 | Net tie | 2 | 2 | GND | Power net — 27 pins share it (see Nets tab) | power:GND symbol
D · Temperature + overheat cutoff
D | J6 | Conn 1×4 (JST-XH) | 1 | Pin_1 | NTC1_ADC | TH1.1, R14.2, C10.1, J3.2 | Label NTC1_ADC
D | J6 | Conn 1×4 (JST-XH) | 2 | Pin_2 | GND | Power net — 27 pins share it (see Nets tab) | power:GND symbol
D | J6 | Conn 1×4 (JST-XH) | 3 | Pin_3 | NTC2 | TH2.1, R13.2, C11.1, U2.3 | Label NTC2
D | J6 | Conn 1×4 (JST-XH) | 4 | Pin_4 | GND | Power net — 27 pins share it (see Nets tab) | power:GND symbol
D | TH1 | NTC 10k | 1 | ~ | NTC1_ADC | J6.1, R14.2, C10.1, J3.2 | Label NTC1_ADC
D | TH1 | NTC 10k | 2 | ~ | GND | Power net — 27 pins share it (see Nets tab) | power:GND symbol
D | R14 | 10k | 1 | ~ | +3V3 | Power net — 13 pins share it (see Nets tab) | power:+3V3 symbol
D | R14 | 10k | 2 | ~ | NTC1_ADC | J6.1, TH1.1, C10.1, J3.2 | Label NTC1_ADC
D | C10 | 100nF | 1 | ~ | NTC1_ADC | J6.1, TH1.1, R14.2, J3.2 | Label NTC1_ADC
D | C10 | 100nF | 2 | ~ | GND | Power net — 27 pins share it (see Nets tab) | power:GND symbol
D | TH2 | NTC 10k | 1 | ~ | NTC2 | J6.3, R13.2, C11.1, U2.3 | Label NTC2
D | TH2 | NTC 10k | 2 | ~ | GND | Power net — 27 pins share it (see Nets tab) | power:GND symbol
D | R13 | 10k | 1 | ~ | +3V3 | Power net — 13 pins share it (see Nets tab) | power:+3V3 symbol
D | R13 | 10k | 2 | ~ | NTC2 | J6.3, TH2.1, C11.1, U2.3 | Label NTC2
D | C11 | 100nF | 1 | ~ | NTC2 | J6.3, TH2.1, R13.2, U2.3 | Label NTC2
D | C11 | 100nF | 2 | ~ | GND | Power net — 27 pins share it (see Nets tab) | power:GND symbol
D | RV2 | 10k trim | 1 | 1 | +3V3 | Power net — 13 pins share it (see Nets tab) | power:+3V3 symbol
D | RV2 | 10k trim | 2 | wiper | THRESH | U2.2 | Wire (or label THRESH)
D | RV2 | 10k trim | 3 | 3 | GND | Power net — 27 pins share it (see Nets tab) | power:GND symbol
D | U2 | LM393 · unit A | 3 | + | NTC2 | J6.3, TH2.1, R13.2, C11.1 | Label NTC2
D | U2 | LM393 · unit A | 2 | − | THRESH | RV2.2 | Wire (or label THRESH)
D | U2 | LM393 · unit A | 1 | OUT | GATE | Q1.1, R11.2, R12.1 | Label GATE (used in 2 blocks)
D | U2 | LM393 · unit B (unused) | 5 | + | GND | Power net — 27 pins share it (see Nets tab) | power:GND symbol
D | U2 | LM393 · unit B (unused) | 6 | − | GND | Power net — 27 pins share it (see Nets tab) | power:GND symbol
D | U2 | LM393 · unit B (unused) | 7 | OUT | (no connect) | nothing | No-Connect flag (Q)
D | U2 | LM393 · unit C (power) | 8 | V+ | +5V | Power net — 4 pins share it (see Nets tab) | power:+5V symbol
D | U2 | LM393 · unit C (power) | 4 | GND | GND | Power net — 27 pins share it (see Nets tab) | power:GND symbol
D | C7 | 100nF | 1 | ~ | +5V | Power net — 4 pins share it (see Nets tab) | power:+5V symbol
D | C7 | 100nF | 2 | ~ | GND | Power net — 27 pins share it (see Nets tab) | power:GND symbol
E · Flight computer + sensor plugs
E | J2 | Conn 1×3 (JST-XH) | 1 | Pin_1 | +5V | Power net — 4 pins share it (see Nets tab) | power:+5V symbol
E | J2 | Conn 1×3 (JST-XH) | 2 | Pin_2 | +3V3 | Power net — 13 pins share it (see Nets tab) | power:+3V3 symbol
E | J2 | Conn 1×3 (JST-XH) | 3 | Pin_3 | GND | Power net — 27 pins share it (see Nets tab) | power:GND symbol
E | C8 | 10µF | 1 | + | +3V3 | Power net — 13 pins share it (see Nets tab) | power:+3V3 symbol
E | C8 | 10µF | 2 | − | GND | Power net — 27 pins share it (see Nets tab) | power:GND symbol
E | J3 | Conn 1×5 (JST-XH) | 1 | Pin_1 | HB_ADC | R5.2, C3.1 | Label HB_ADC
E | J3 | Conn 1×5 (JST-XH) | 2 | Pin_2 | NTC1_ADC | J6.1, TH1.1, R14.2, C10.1 | Label NTC1_ADC
E | J3 | Conn 1×5 (JST-XH) | 3 | Pin_3 | PWM | R11.1 | Label PWM
E | J3 | Conn 1×5 (JST-XH) | 4 | Pin_4 | SCL | J7.3, J8.3, J9.3 | Label SCL
E | J3 | Conn 1×5 (JST-XH) | 5 | Pin_5 | SDA | J7.4, J8.4, J9.4 | Label SDA
E | J7 | Conn 1×4 (JST-XH) | 1 | Pin_1 | +3V3 | Power net — 13 pins share it (see Nets tab) | power:+3V3 symbol
E | J7 | Conn 1×4 (JST-XH) | 2 | Pin_2 | GND | Power net — 27 pins share it (see Nets tab) | power:GND symbol
E | J7 | Conn 1×4 (JST-XH) | 3 | Pin_3 | SCL | J3.4, J8.3, J9.3 | Label SCL
E | J7 | Conn 1×4 (JST-XH) | 4 | Pin_4 | SDA | J3.5, J8.4, J9.4 | Label SDA
E | J8 | Conn 1×5 (JST-XH) | 1 | Pin_1 | +3V3 | Power net — 13 pins share it (see Nets tab) | power:+3V3 symbol
E | J8 | Conn 1×5 (JST-XH) | 2 | Pin_2 | GND | Power net — 27 pins share it (see Nets tab) | power:GND symbol
E | J8 | Conn 1×5 (JST-XH) | 3 | Pin_3 | SCL | J3.4, J7.3, J9.3 | Label SCL
E | J8 | Conn 1×5 (JST-XH) | 4 | Pin_4 | SDA | J3.5, J7.4, J9.4 | Label SDA
E | J8 | Conn 1×5 (JST-XH) | 5 | Pin_5 | GND | Power net — 27 pins share it (see Nets tab) | power:GND symbol
E | J9 | Conn 1×4 (JST-XH) | 1 | Pin_1 | +3V3 | Power net — 13 pins share it (see Nets tab) | power:+3V3 symbol
E | J9 | Conn 1×4 (JST-XH) | 2 | Pin_2 | GND | Power net — 27 pins share it (see Nets tab) | power:GND symbol
E | J9 | Conn 1×4 (JST-XH) | 3 | Pin_3 | SCL | J3.4, J7.3, J8.3 | Label SCL
E | J9 | Conn 1×4 (JST-XH) | 4 | Pin_4 | SDA | J3.5, J7.4, J8.4 | Label SDA

Sheet: Nets
Net | Type | How to draw it | Pins on this net | Pins expected | Pins found in Wiring tab | Check
+5V | Power | power:+5V symbol | R1.1, U2.8, C7.1, J2.1 | 4 | 4 | OK
+3V3 | Power | power:+3V3 symbol | U3.C, J1.3, R6.1, U1.8, C5.1, R14.1, R13.1, RV2.1, J2.2, C8.1, J7.1, J8.1, J9.1 | 13 | 13 | OK
+14V8 | Power | power:VCC symbol, change Value to +14V8 | J4.1, C6.1, J5.1, R8.1, R9.1, R10.1 | 6 | 6 | OK
GND | Ground | power:GND symbol | U3.K, J1.2, RV1.2, RV1.3, C3.2, R7.2, C4.2, U1.4, C5.2, NT1.2, J6.2, J6.4, TH1.2, C10.2, TH2.2, C11.2, RV2.3, U2.5, U2.6, U2.4, C7.2, J2.3, C8.2, J7.2, J8.2, J8.5, J9.2 | 27 | 27 | OK
GNDPWR | Ground | power:GNDPWR symbol | J4.2, C6.2, Q1.3, R12.2, NT1.1 | 5 | 5 | OK
LED_A | Analog | Wire (or label LED_A) | U3.A, J1.1, R1.2 | 3 | 3 | OK
SENSE | Analog | Wire (or label SENSE) | U3.E, J1.4, RV1.1, C1.1 | 4 | 4 | OK
HP_IN | Analog | Wire (or label HP_IN) | C1.2, R2.1, U1.3 | 3 | 3 | OK
FB | Analog | Wire (or label FB) | U1.2, R3.1, R4.1, C2.1 | 4 | 4 | OK
AMP_OUT | Analog | Wire (or label AMP_OUT) | U1.1, R4.2, C2.2, R5.1 | 4 | 4 | OK
HB_ADC | Analog | Label HB_ADC | R5.2, C3.1, J3.1 | 3 | 3 | OK
REF_DIV | Analog | Wire (or label REF_DIV) | R6.2, R7.1, C4.1, U1.5 | 4 | 4 | OK
VREF | Analog | Label VREF (used in 2 blocks) | R2.2, R3.2, U1.6, U1.7 | 4 | 4 | OK
NTC1_ADC | Analog | Label NTC1_ADC | J6.1, TH1.1, R14.2, C10.1, J3.2 | 5 | 5 | OK
NTC2 | Analog | Label NTC2 | J6.3, TH2.1, R13.2, C11.1, U2.3 | 5 | 5 | OK
THRESH | Analog | Wire (or label THRESH) | RV2.2, U2.2 | 2 | 2 | OK
PWM | Control | Label PWM | R11.1, J3.3 | 2 | 2 | OK
GATE | Control | Label GATE (used in 2 blocks) | Q1.1, R11.2, R12.1, U2.1 | 4 | 4 | OK
HEATER_LO | Heater | Label HEATER_LO | J5.2, R8.2, R9.2, R10.2, Q1.2 | 5 | 5 | OK
SCL | Digital I²C | Label SCL | J3.4, J7.3, J8.3, J9.3 | 4 | 4 | OK
SDA | Digital I²C | Label SDA | J3.5, J7.4, J8.4, J9.4 | 4 | 4 | OK
(no connect) |  | No-Connect flag | U2.7

Sheet: Connectors
Plugs and cables — what each wire goes to off the board
Plug | Type | Pin | Net | Wire goes to (other end) | Suggested wire colour
J1 · Sensor cable | JST-XH 4-pin | 1 | LED_A | TCRT5000 pin A (LED anode) | Green
 |  | 2 | GND | TCRT5000 pin K (LED cathode) | Black
 |  | 3 | +3V3 | TCRT5000 pin C (collector) | Red
 |  | 4 | SENSE | TCRT5000 pin E (emitter) | Yellow
J2 · Flight computer power | JST-XH 3-pin | 1 | +5V | Flight computer 5V | Red
 |  | 2 | +3V3 | Flight computer 3V3 | Orange
 |  | 3 | GND | Flight computer GND | Black
J3 · Flight computer signals | JST-XH 5-pin | 1 | HB_ADC | PB0 (ADC) | Yellow
 |  | 2 | NTC1_ADC | PB1 (ADC) | White
 |  | 3 | PWM | PC6 (PWM) | Green
 |  | 4 | SCL | PD12 (I²C4 SCL) | Blue
 |  | 5 | SDA | PD13 (I²C4 SDA) | Purple
J4 · 14.8 V in | XT30 | 1 | +14V8 | Port X8 + (14.8 V) | Red, 20 AWG
 |  | 2 | GNDPWR | Port X8 − | Black, 20 AWG
J5 · Heater | KF2EDG 2-pin | 1 | +14V8 | Heater bank: R8, R9, R10 joined at one end | Red
 |  | 2 | HEATER_LO | Heater bank: R8, R9, R10 joined at other end | Black
J6 · Thermistors | JST-XH 4-pin | 1 | NTC1_ADC | TH1 leg 1 (taped to heater) | White
 |  | 2 | GND | TH1 leg 2 | Black
 |  | 3 | NTC2 | TH2 leg 1 (taped to heater) | Brown
 |  | 4 | GND | TH2 leg 2 | Black
J7 · SHT21 module | JST-XH 4-pin | 1 | +3V3 | Module VIN | Red
 |  | 2 | GND | Module GND | Black
 |  | 3 | SCL | Module SCL | Blue
 |  | 4 | SDA | Module SDA | Purple
J8 · BMP280 module | JST-XH 5-pin | 1 | +3V3 | Module VCC | Red
 |  | 2 | GND | Module GND | Black
 |  | 3 | SCL | Module SCL | Blue
 |  | 4 | SDA | Module SDA | Purple
 |  | 5 | GND | Module SDO (sets address 0x76) | Black
J9 · MAX30100 module | JST-XH 4-pin | 1 | +3V3 | Module VIN | Red
 |  | 2 | GND | Module GND | Black
 |  | 3 | SCL | Module SCL | Blue
 |  | 4 | SDA | Module SDA | Purple
Note: the MAX30100 board's I²C pull-ups go to 1.8 V on many cheap modules. If the STM32 can't read it, that's why — it's the backup sensor anyway.
