notazizelse/Orbita26/budget/SnailPulse_BOM_v2_RU.xlsx

Orbita SnailPulse — смета комплектующих (Microelectronica, electron.uz)
Зелёные строки — добавлено после сверки со схемой · оранжевые — изменено количество
Компонент | Маркировка | Характеристики | Ссылка | Фото | Кол-во | Запас | Всего | Цена за шт (сум) | Сумма (сум) | Название на сайте (показать продавцу) | Примечание
Активные компоненты (микросхемы, транзисторы) |  | Отдел радиодеталей · +998 95 199-04-61
Операционный усилитель, сдвоенный | MCP6002-I/P | DIP-8 · rail-to-rail вход/выход · 1,8–6 В · 1 МГц | Открыть (https://electron.uz/product/mcp6002-dip8/) |  | 1 | 1 |  | 6800 |  | MCP6002 DIP8 | U2 — усилитель + буфер опорного 1,65 В
Компаратор, сдвоенный | LM393N | DIP-8 · выход с открытым коллектором · питание 2–36 В | Открыть (https://electron.uz/product/lm393n-dip8/) |  | 1 | 1 |  | 3400 |  | LM393N DIP8 | U5 — аппаратное отключение нагревателя при 40 °C
MOSFET N-канальный, логический уровень | IRLZ44N | TO-220 · 55 В · 47 А · 22 мОм при Vgs 5 В | Открыть (https://electron.uz/product/irlz44/) | нет фото на сайте | 1 | 1 |  | 15000 |  | IRLZ44N TO220 | Q1 — ключ нагревателя
Панелька для микросхемы | SCS-8 | DIP-8 · шаг 2,54 мм | Открыть (https://electron.uz/product/scs-8-dip-8pin-%D0%BF%D0%B0%D0%BD%D0%B5%D0%BB%D1%8C%D0%BA%D0%B8-%D0%BF%D0%BE%D0%B4-%D0%BC%D0%B8%D0%BA%D1%80%D0%BE%D1%81%D1%85%D0%B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) |  | 2 | 2 |  | 500 |  | SCS-8 Dip 8pin панельки | Для U2 и U5
 |  |  |  |  |  |  |  | Итого
Пассивные компоненты |  | Отдел радиодеталей · +998 95 199-04-61
Набор резисторов | CF 0,25 Вт, набор 300 шт | 30 номиналов × 10 шт · 0,25 Вт · ±5 % · выводные | Открыть (https://electron.uz/product/%D0%BD%D0%B0%D0%B1%D0%BE%D1%80-%D1%80%D0%B5%D0%B7%D0%B8%D1%81%D1%82%D0%BE%D1%80%D0%BE%D0%B2-025%D0%B2%D1%82-300-%D1%88%D1%8230-%D0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) |  | 1 | 0 |  | 20000 |  | Набор резисторов 0,25Вт 300 шт | Нужно: 220 Ом ×1, 1 кОм ×3, 10 кОм ×5, 100 кОм ×1, 1 МОм ×1 — проверить, что 220 Ом и 1 МОм есть в наборе
Мощный резистор (нагреватель) | 150 Ом 5 Вт | 5 Вт · ±5 % · керамический (цементный) · аксиальный | Открыть (https://electron.uz/product/150om-5w/) |  | 3 | 2 |  | 2065 |  | 150om — 5W | R8–R10, 3 параллельно = 50 Ом
NTC-термистор | MF58 10K | 10 кОм при 25 °C · B ≈ 3950 · стеклянный, аксиальный | Открыть (https://electron.uz/product/%D1%82%D0%B5%D1%80%D0%BC%D0%BE%D1%80%D0%B5%D0%B7%D0%B8%D1%81%D1%82%D0%BE%D1%80-ntc-mf58-10k/) |  | 2 | 2 |  | 1000 |  | Терморезистор NTC MF58 10K | TH1 (прошивка), TH2 (аппаратная защита)
Подстроечный резистор 50 кОм | 3296W-1-503LF | 50 кОм · 25 оборотов · регулировка сверху · выводной | Открыть (https://electron.uz/product/50kom-3296w-1-503lf/) |  | 1 | 1 |  | 2000 |  | 50KOM 3296W-1-503LF | RV3 — нагрузка датчика
Подстроечный резистор 10 кОм | 3296W-1-103LF | 10 кОм · 25 оборотов · регулировка сверху · выводной | Открыть (https://electron.uz/product/10kom-3296w-1-103lf/) |  | 1 | 1 |  | 2000 |  | 10KOM 3296W-1-103LF | RV2 — порог отключения
Керамический конденсатор 1 мкФ | 105 | 1 мкФ · 50 В · многослойный керамический · выводной | Открыть (https://electron.uz/product/105-50v-1mf-ceramic/) | нет фото на сайте | 1 | 2 |  | 500 |  | 105-50V (1mf) ceramic | C11 — нужен только 1 (было 6)
Керамический конденсатор 470 нФ | 474 | 470 нФ · 50 В · многослойный керамический · выводной | Открыть (https://electron.uz/product/474-50v-470nf-ceramic/) | нет фото на сайте | 1 | 2 |  | 500 |  | 474-50V (470nf) ceramic | C2 — нужен только 1 (было 4)
Керамический конденсатор 100 нФ | 104 | 100 нФ · 50 В · керамический дисковый · выводной | Открыть (https://electron.uz/product/104-50v-ceramicdisk/) | нет фото на сайте | 5 | 5 |  | 500 |  | 104-50V ceramicDisk | C3, C5, C7, C8, C9
Электролитический конденсатор 10 мкФ | 10 мкФ 50 В | 10 мкФ · 50 В · радиальный · 5 × 11,5 мм | Открыть (https://electron.uz/product/10mf-50v-5x115/) |  | 3 | 2 |  | 1000 |  | 10MF-50V 5×11,5 | C4, C6, C10 · на сайте 0 сум, цена примерная
 |  |  |  |  |  |  |  | Итого
Модули и датчики |  | Отдел Arduino / модулей · +998 95 196-04-61
Модуль ИК-датчика отражения | HW-511 / FZ0225 (TCRT5000) | ИК-светодиод + фототранзистор · TCRT5000 выпаять с модуля | Открыть (https://electron.uz/product/fz0225-%D0%BC%D0%BE%D0%B4%D1%83%D0%BB%D1%8C-%D0%B4%D0%B0%D1%82%D1%87%D0%B8%D0%BA%D0%B0-%D0%BE%D1%82%D1%81%D0%BB%D0%B5%D0%B6%D0%B8%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) |  | 1 | 1 |  | 8000 |  | FZ0225 / HW-511 Модуль датчика отслеживания линии | U1 — датчик сердцебиения
Модуль пульсоксиметра | GY-MAX30100 | I²C 0x57 · 3,3 В · резервный датчик пульса | Открыть (https://electron.uz/product/%D0%BE%D0%BA%D1%81%D0%B8%D0%BC%D0%B5%D1%82%D1%80-%D0%BF%D1%83%D0%BB%D1%8C%D1%81%D0%B0-gy-30100-max30100/) |  | 1 | 0 |  | 20000 |  | Оксиметр пульса GY-30100 MAX30100 | J9 · дешёвые платы подтягивают I²C к 1,8 В — убрать подтягивающие резисторы
Модуль температуры и влажности | GY-21 (SHT21) | I²C 0x40 · 3,3 В | Открыть (https://electron.uz/product/gy-21-sht21-%D1%86%D0%B8%D1%84%D1%80%D0%BE%D0%B2%D0%BE%D0%B9-%D0%BC%D0%BE%D0%B4%D1%83%D0%BB%D1%8C-%D0%B4%D0%B0%D1%82%D1%87%D0%B8%D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) |  | 1 | 0 |  | 20000 |  | GY-21 SHT21 датчик влажности и температуры | J7
Модуль давления | GY-BMP280 | I²C 0x76 (SDO → GND) · 3,3 В | Открыть (https://electron.uz/product/%D0%B1%D0%B0%D1%80%D0%BE%D0%BC%D0%B5%D1%82%D1%80-bmp280-%D0%B4%D0%B0%D1%82%D1%87%D0%B8%D0%BA-%D0%B0%D1%82%D0%BC%D0%BE%D1%81%D1%84%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) |  | 1 | 0 |  | 10000 |  | Барометр BMP280 | J8 · на фото в магазине плата BME280
 |  |  |  |  |  |  |  | Итого
Разъёмы, плата и провода |  | Спросить в любом отделе
Силовой разъём | XT30 | 30 А · 2 контакта · для 14,8 В от X8 | Открыть (https://electron.uz/product/xt30-%D1%80%D0%B0%D0%B7%D1%8A%D0%B5%D0%BC-2/) |  | 1 | 1 |  | 5000 |  | XT30 Разъем | J2
Клеммник 2-контактный | KF2EDG-2P | шаг 5,08 мм · разъёмный · продаётся парой | Открыть (https://electron.uz/product/%D0%BA%D0%BB%D0%B5%D0%BC%D0%BC%D0%B0-kf2edg-2pin-508mm-%D0%BF%D0%B0%D1%80%D0%B0/) |  | 1 | 1 |  | 1000 |  | Клемма KF2EDG-2pin 5,08mm пара | J3 — выход нагревателя, единственный клеммник на схеме (было 3)
Набор разъёмов JST-XH | XH2.54, 80 шт | 2/3/4/5 контактов · папа + мама · 2,54 мм | Открыть (https://electron.uz/product/%d0%bd%d0%b0%d0%b1%d0%be%d1%80-%d1%80%d0%b0%d0%b7%d1%8a%d0%b5%d0%bc%d0%be%d0%b2-xh2-54-80%d1%88%d1%822p-3p-4p-5p-2-54%d0%bc%d0%bc-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) |  | 1 | 0 |  | 27000 |  | Набор Разъемов XH2.54 80шт, 2p 3p 4p 5p | J1, J4, J7, J9 — 4 контакта · J6, J8 — 5 · J5 — 3. Нужен обжимной инструмент
Кабель к датчику, 4 жилы | Телефонный кабель 2 м | плоский кабель RJ11 · проверить, что 4 жилы (6P4C) | Открыть (https://electron.uz/product/2%d0%bc-%d0%ba%d0%b0%d0%b1%d0%b5%d0%bb%d1%8c-%d1%82%d0%b5%d0%bb%d0%b5%d1%84%d0%be%d0%bd%d0%bd%d0%be%d0%b9-%d0%bb%d0%b8%d0%bd%d0%b8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) | нет фото на сайте | 1 | 0 |  | 4000 |  | 2м Кабель телефонной линии | J1 → TCRT5000 на раковине
Провод силиконовый 24 AWG | 3239 24AWG, 10 м | 0,21 мм² · силикон · гибкий | Открыть (https://electron.uz/product/3239-24awg021mm2-10%d0%bc%d0%b5%d1%82%d1%80-%d0%bf%d1%80%d0%be%d0%b2%d0%be%d0%b4-%d0%bc%d0%be%d0%bd%d1%82%d0%b0%d0%b6%d0%bd%d1%8b%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) |  | 1 | 0 |  | 15000 |  | 3239 24AWG 10метр провод силиконовый | Монтаж платы, кабели к модулям (J7–J9), выводы термисторов и нагревателя
Набор термоусадки | XCL, 100 шт | Ø 2–7 мм · отрезки по 20 см | Открыть (https://electron.uz/product/%d0%ba%d0%b5%d0%bc%d0%b1%d1%80%d0%b8%d0%ba-%d1%82%d0%b5%d1%80%d0%bc%d0%be%d1%83%d1%81%d0%b0%d0%b4%d0%ba%d0%b0-%d0%bd%d0%b0%d0%b1%d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) |  | 1 | 0 |  | 30000 |  | Кембрик термоусадка набор XCL 100шт 20см Ø2-7мм | Изоляция соединений датчика, термисторов и нагревателя
Каптоновый скотч 10 мм | 10 мм × 30 м | полиимид · термостойкий | Открыть (https://electron.uz/product/10mm-x30m-%d0%ba%d0%b0%d0%bf%d1%82%d0%be%d0%bd%d0%be%d0%b2%d1%8b%d0%b9-%d1%81%d0%ba%d0%be%d1%82%d1%87-%d1%82%d0%b5%d1%80%d0%bc%d0%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) |  | 1 | 0 |  | 15000 |  | 10mm x30m каптоновый скотч Koptan | Крепление NTC на пластине нагревателя и проводов · на фото в магазине рулон 50 мм
Защитное покрытие (цапонлак) | ЦапонЛак 30 мл | бесцветный · наносится кисточкой | Открыть (https://electron.uz/?s=%D1%86%D0%B0%D0%BF%D0%BE%D0%BD%D0%BB%D0%B0%D0%BA&post_type=product) |  | 1 | 0 |  | 14000 |  | ЦапонЛак 30мл бесцветный | Защита платы от конденсата на холоде · цена из списка от 19 октября
Макетная плата | 9 × 15 см, односторонняя | шаг 2,54 мм · обрезать до 76 × 76 мм | Открыть (https://electron.uz/product/9x15-%D0%BC%D0%BE%D0%BD%D1%82%D0%B0%D0%B6%D0%BD%D0%B0%D1%8F-%D0%BF%D0%BB%D0%B0%D1%82%D0%B0-%D0%B7%D0%B5%D0%BB-1%D1%81%D1%82%D0%BE%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) |  | 1 | 1 |  | 10000 |  | 9×15 Монтажная плата зел 1стороняя
 |  |  |  |  |  |  |  | Итого
 |  |  |  |  |  |  |  | ВСЕГО
Не входит в смету: припой, флюс и обжимной инструмент для JST-XH — взять в лаборатории. Убрано по сравнению с прошлой версией: KF2EDG 4-pin ×2 (J5/J6 на схеме — JST-XH).
