notazizelse/Orbita26/hardware/perfboard/SnailPulse_perfboard_build.html

# SnailPulse Perfboard Build

Rev C, heartbeat only. Every part sits on a real 2.54 mm hole grid, 30 × 30 holes (76 mm square). Tap a step, a part or a net to light up exactly what goes where. Bottom view is mirrored, the way the board looks when you flip it to solder.

Updated 24 Oct for the parts you actually have. New step 1 (measure parts, desolder the TCRT5000). Every step now has a Requirements tab: the multimeter checks to pass before you start the next step. Your parts list, answered ↓

Updated 30 Oct: two snails. Snail 1 wears the TCRT5000 (amplifier → PB0), snail 2 the MAX30100 (I²C, 0x57); each gets its own heart rate. A DHT-11 (data → PC6) and an MQ-7 (AO → PB1) are on the board, both powered from +5 V since 30 Oct; the MQ-7's AO reaches PB1 through a 10 kΩ / 20 kΩ divider (R20, R21). There is one BMP280 (SDO → GND, 0x76); the second one planned on 29 Oct was dropped. Step 10 wires the DHT-11 and MQ-7, and step 11 runs the new sensor-test sketch. Which code to upload where, the IntroBus_L pin map, and the voltages to check ↓

Board 76.2 × 76.2 mmHoles c1–c30 · r1–r30Checked against Orbita26 rev C netlist + 29 Oct sensorsParts your list, 24 Oct + DHT-11, MQ-7

Top · parts side Bottom · solder side

Show copper traces through the board Off-board wiring

1×1.5×2.2×

Clear highlight

## Build steps

## Inspector

Tap any part, pad or wire on the board to see each pin, its hole and what it connects to.

## Which code goes where, and where each wire lands

Every sketch goes to the flight controller. The SnailPulse board has no processor, and the communication and power boards keep the organizers' firmware.

### Code → board

# | Sketch (open the .ino) | Upload to | When | What you see

1 | firmware/tools/SensorTest/SensorTest.ino | Flight controller (STM32H750) | After step 11's power checks pass. Run it first. | Serial Monitor on the FC's USB-C, 115200: a PASS / WARN / FAIL line for each of the 12 sensors, then live values every 2 s. Keys: t test again, p plotter stream, s I²C scan.
2 | firmware/tools/HB_Tune/HB_Tune.ino | Flight controller | Tuning RV3 on the live snail | Serial Plotter: hb, hb_dc and mq7_mV at 50 Hz
3 | firmware/SnailPulse_Flight/SnailPulse_Flight.ino | Flight controller | Flight. Firmware 1.5 (30 Oct): heater off, GY-21 (SHT21) not used, heart rates of two snails (snail 1 TCRT5000 on PB0, snail 2 MAX30100 on I²C), the DHT-11 on PC6 and the MQ-7 on PB1 (both on 5 V), and the BMP280 (0x76). Needs IntroStratLib, STM32SD and FatFs. | Packets on the ground monitor. SNAIL shows both snails' heart rates every 2 s; ENV shows the SHT21, the BMP280, the DHT-11 and the MQ-7 every 4 s.

Arduino IDE settings (same for all three)

Board manager URL https://github.com/stm32duino/BoardManagerFiles/raw/main/package_stmicroelectronics_index.json Package version STM32 MCU based boards 2.12.0 (SensorTest + HB_Tune also build on 3.0.0; the flight code was only built on 2.12, so pick 2.12.0 for everything) Tools → Board STM32 MCU based boards → Generic STM32H7 Series Board part number Generic H750VBTx (STM32H750VBTx) Upload method STM32CubeProgrammer (SWD) ← install STM32CubeProgrammer first ST-Link → PROG SWCLK → CLK · SWDIO → SWD · GND → GND (not its 3.3 V when the power module is on) BOOT0 jumper on 0 (back of the FC), then Upload Serial Monitor FC USB-C port, 115200 baud

### IntroBus_L on the flight controller

The 2 × 20 payload header, rows as printed in the IntroSat guide (p. 5, "view of the board from above"). Highlighted pins carry a SnailPulse wire. Check the names on your FC's silkscreen before plugging in. Never use IntroBus_S, the 16-pin header.

function | left | row | right | function → wire

### Before the sensor test: what to measure

Black probe on GND. All of these are also in the Requirements tabs of steps 10 and 11.

○ | Power off. FC +5V ↔ FC +3V3: no beep. FC +5V ↔ GND in Ω mode: ≈30–40 Ω with the MQ-7 plugged in (its heater), high or OL without it. Under 20 Ω is a short. FC +3V3 ↔ GND: kΩ.
○ | Power off. DHT DATA ↔ GND: no beep. DATA ↔ +5V: 4.7–10 kΩ (pull-up). With the MQ-7 unplugged: FC PB1 pad ↔ GND ≈20 kΩ (R21), MQ-7 AO pad ↔ PB1 pad ≈10 kΩ (R20). On the MQ-7 module, AO ↔ GND: ≈1 kΩ or ≈10 kΩ (its load resistor; put it in MQ7_RL_OHM). BMP280 SDO ↔ its GND: beep.
V | FC +5V pad 4.75–5.25 V · FC +3V3 pad 3.20–3.40 V, measured while the MQ-7 heats
V | U2 pin 7 (VREF) 1.60–1.70 V · PB0 / HB_ADC 1.2–2.1 V · SENSE 0.8–1.2 V (set with RV3) · TCRT A 1.1–1.4 V
V | SCL, SDA idle 3.0–3.3 V (1.8–2.6 V: remove the MAX30100 pull-ups)
V | DHT-11 VCC 4.75–5.25 V · DHT DATA idle 4.7–5.2 V
V | MQ-7 VCC 4.75–5.25 V · MQ-7 AO ≈0.05–2 V in clean air after 3 min · FC PB1 pad = AO × 2/3, never above 3.3 V
V | BMP280 SDO 0 V (low = 0x76)

The MQ-7 runs on +5 V, its rated heater power, so its ppm chart applies after warm-up. Its AO can then reach 5 V, and PB1 is not 5 V-tolerant as an analog input: R20 (10 kΩ, AO → PB1) and R21 (20 kΩ, PB1 → GND) must be in place before you power it. With power on, the FC PB1 pad must always read below 3.3 V. The firmware scales the reading back, so the ground station shows the voltage at the module.

## Your parts, checked against the build

Your Numbers list row by row: where each part goes, what's left over, and answers to the notes column.

### Can we still do every experiment?

✓ | Snail 1's heartbeat through the shell (TCRT5000 → MCP6002 amplifier → PB0). Every part is on your list. The TCRT5000 comes off one HW-511.
✓ | Box air: temperature and pressure (BMP280, 0x76), humidity (DHT-11). The GY-21 (SHT21) was removed on 30 Oct.
✓ | Snail 2's heartbeat (MAX30100 on the second snail's shell), after one check of its I²C pull-ups in step 11.
✓ | Second temperature/humidity reading + CO gas (added 29 Oct): DHT-11 on PC6 and MQ-7 on PB1, both on +5 V (the MQ-7 heater at its rated power, AO through a divider).
✗ | Heater at 20 °C + 40 °C hardware cutoff. You dropped it on purpose: insulation instead. You still have most of it (IRLZ44N, LM393, XT30, 2 × 150 Ω). Missing: the two 10 k NTC thermistors and the third 150 Ω. With two resistors it would be 75 Ω, 2.9 W at 14.8 V instead of 4.4 W.
✗ | ADS-B receiver idea. Not with these parts. It needs an SDR receiver for 1090 MHz, its antenna and a computer to decode. None of that is on this list.

With no heater, heart rate against box temperature becomes your main result. That makes where the BMP280 and the DHT-11 sit in the box air more important.

### What your parts change in the build

1. New step 1: measure every part and desolder the TCRT5000 from an HW-511. The second HW-511 stays whole as a spare sensor.
2. C3 and C5 use your 104s. The old "still to buy" fallback is gone. The smaller 104s fit the tight spots better.
3. All three of your 474s are used (C2, C11a, C11b), so you have none spare. If one cracks: C2 → five 104 in parallel (0.5 µF, low-pass 3.2 Hz). C11 → one 474 + four 104 (0.87 µF, corner 0.18 Hz). You have enough 104s for one of these fallbacks, not both.
4. 1 MΩ is in your kit, so R15 stays as drawn.
5. These don't go on the board: IRLZ44N, LM393P, 150 Ω 5 W, XT30, 1000 µF.
6. Not on your list but still needed: perfboard, silicone wire, a 4-core cable for the TCRT5000, solder + wick, hot glue. A DIP-8 socket is optional.

### Row by row

Your row | Have | Goes to | Spare | Your note → answer
Resistor pack | 1 | on board R1 220 Ω · R3, R16 1 kΩ · R6, R7, R20 10 kΩ · R21 20 kΩ (or 2 × 10 kΩ) · R17 100 kΩ · R15 1 MΩ | rest of kit | It has every value the board needs. Measure each one in step 1 before soldering, because kits get mixed up.
bmp280 | 1 | off-board Box pressure, I²C 0x76 | 0 | SDO → its own GND sets address 0x76 (wired in step 9). A second BMP280 at 0x77 was planned on 29 Oct and dropped on 30 Oct: one is enough.
dht-11 | 1 | off-board Temp + humidity, DATA → PC6 (step 10) | 0 | Runs on 5 V. Needs a pull-up on DATA: the 3-pin module has one, a bare sensor needs 10 kΩ to VCC. PC6 is 5 V-tolerant, so DATA at 5 V is safe. Accuracy ±2 °C / ±5 %RH. Since the GY-21 was removed (30 Oct) it is the only box humidity sensor.
mq-7 | 1 | off-board CO gas, on +5 V, AO → divider → PB1 (step 10) | 0 | On 5 V its heater gets its rated power, so the ppm curve applies after warm-up. AO then reaches 5 V, so R20 (10 kΩ) and R21 (20 kΩ) scale it to 3.3 V for PB1. Keep the hot can away from the snail and the temperature sensors.
hw-511 | 2 | sensor TCRT5000 from one of them, glued to the shell | 1 module | HW-511 is a robot line-follower board. You only need the black-and-blue TCRT5000 on it. The LM393, pot and LEDs stay on the module.
5w150ohmJ | 2 | not used Was the heater | 2 | "J" on a resistor means ±5 % tolerance.
503 baoter 3296 | 2 | on board RV3 | 1 | "Rv3 I think it is"Yes. 503 = 50 followed by 3 zeros = 50 000 Ω = 50 kΩ. Baoter is the maker; 3296 is the trimmer type.
50V 10uF polarized cap | 5 | on board C4, C10 | 3 | "It is green"Green is just the maker's sleeve colour. What matters: 10 µF, 50 V (far above our 3.3 V), and the stripe marks the minus leg, which is also the shorter one.
irlz44n | 2 | not used Was the heater switch | 2 | Give these to the team whose experiment has the heaters, if they need a MOSFET.
max30100 | 1 | off-board Snail 2 pulse sensor, 0x57 | 0 | Since 30 Oct it measures a second snail, with its own heart rate in every SNAIL packet. IR light and its own chip, read over I²C, so it doesn't depend on the TCRT5000 or our amplifier. Caveat: it's made for fingertips. Through a snail shell it is unproven, so try it on a snail before the flight. It also needs the pull-up check in step 11.
mcp6002 | 2 | on board U2 | 1 | "Idk what this is for"It's the heart of the analog side: two op-amps in one 8-pin chip. Half A amplifies the heartbeat ×101. Through the shell the signal is only a few millivolts, too small for the STM32 to see. Half B makes a steady 1.65 V middle line for the signal to swing around, so it fits the ADC's 0–3.3 V range. Keep the spare in your Moscow kit.
lm393p | 2 | not used Was the overheat cutoff | 2 | "Nor this"A dual comparator: it answers "is voltage A higher than voltage B?" with on/off. In rev B it watched the heater thermistor and cut the heater at 40 °C without any software. Rev C has no heater, so it's not needed. (Each HW-511 carries the same chip in a tiny surface-mount package.)
474 (small cap) | 3 | on board C2, C11a, C11b | 0 | 474 = 47 followed by 4 zeros pF = 470 000 pF = 470 nF. All three are used. Don't lose one; the fallbacks are listed above.
xt30 | 2 | not used Was 14.8 V heater power from X8 | 2 | Rev C runs only on the FC's +5 V and +3.3 V.
104 (small cap) | 5 | on board C3, C5 (from either 104 row) | 8 | 104 = 10 followed by 4 zeros pF = 100 nF.
104, even smaller | 5 | on board Best choice for C3, C5 | | Same 100 nF. Smaller usually means multilayer ceramic or a lower voltage rating. Both are fine at 3.3 V, and the small ones fit better between the rails.
1000uF 16V | 2 | not used | 2 | Not part of the design. Keep it off the 14.8 V battery line: a fully charged 4S pack is 16.8 V, above its 16 V rating.

## What each part looks like and how to find its pins
