notazizelse/Orbita26/hardware/SnailPulse_revC_heartbeat_only.pdf

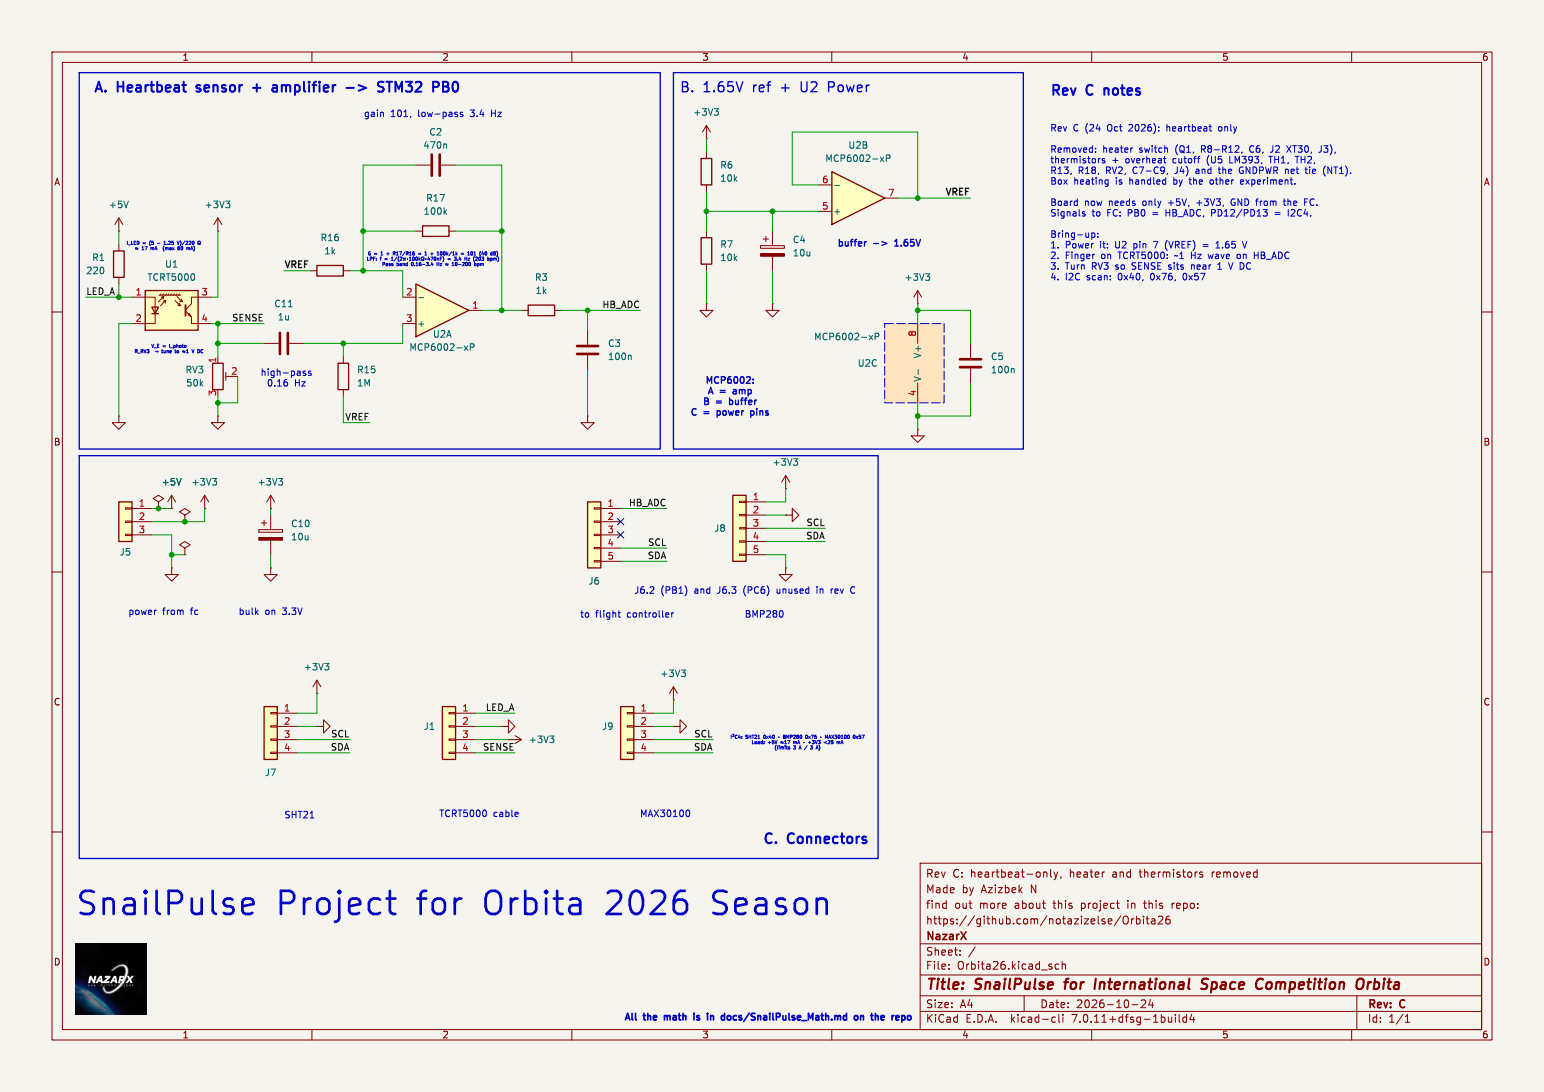
[picture p130: page 1]

2. Finger on TCRT5000: ~1 Hz wave on HB_ADC
3. Turn RV3 so SENSE sits near 1 V DC

J6.2 (PB1) and J6.3 (PC6) unused in rev C

SnailPulse Project for Orbita 2026 Season

https://github.com/notazizelse/Orbita26
File: Orbita26.kicad_sch Sheet: / NazarX
