notazizelse/Orbita26/hardware/Orbita26_schematic.pdf

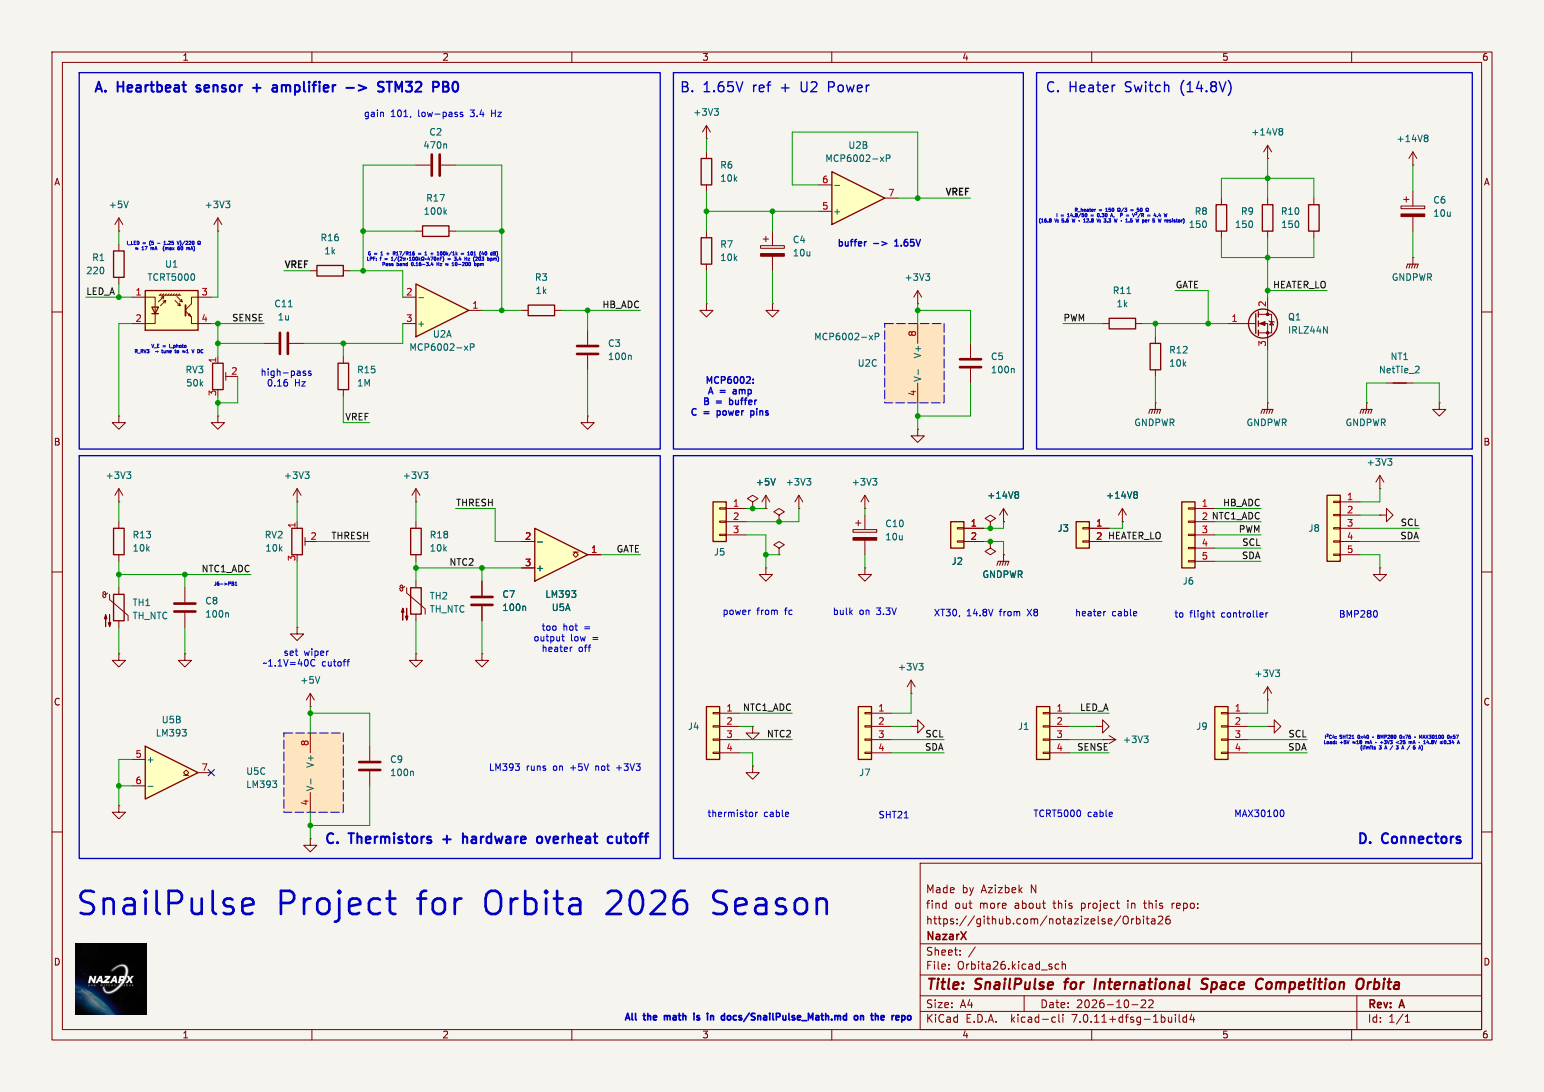
[picture p131: page 1]

MCP6002: A = amp B = buffer C = power pins

LM393 runs on +5V not +3V3 SnailPulse Project for Orbita 2026 Season

C. Thermistors + hardware overheat cutoff

https://github.com/notazizelse/Orbita26
File: Orbita26.kicad_sch Sheet: / NazarX
