notazizelse/Orbita26/hardware/SnailPulse_wiring.pdf

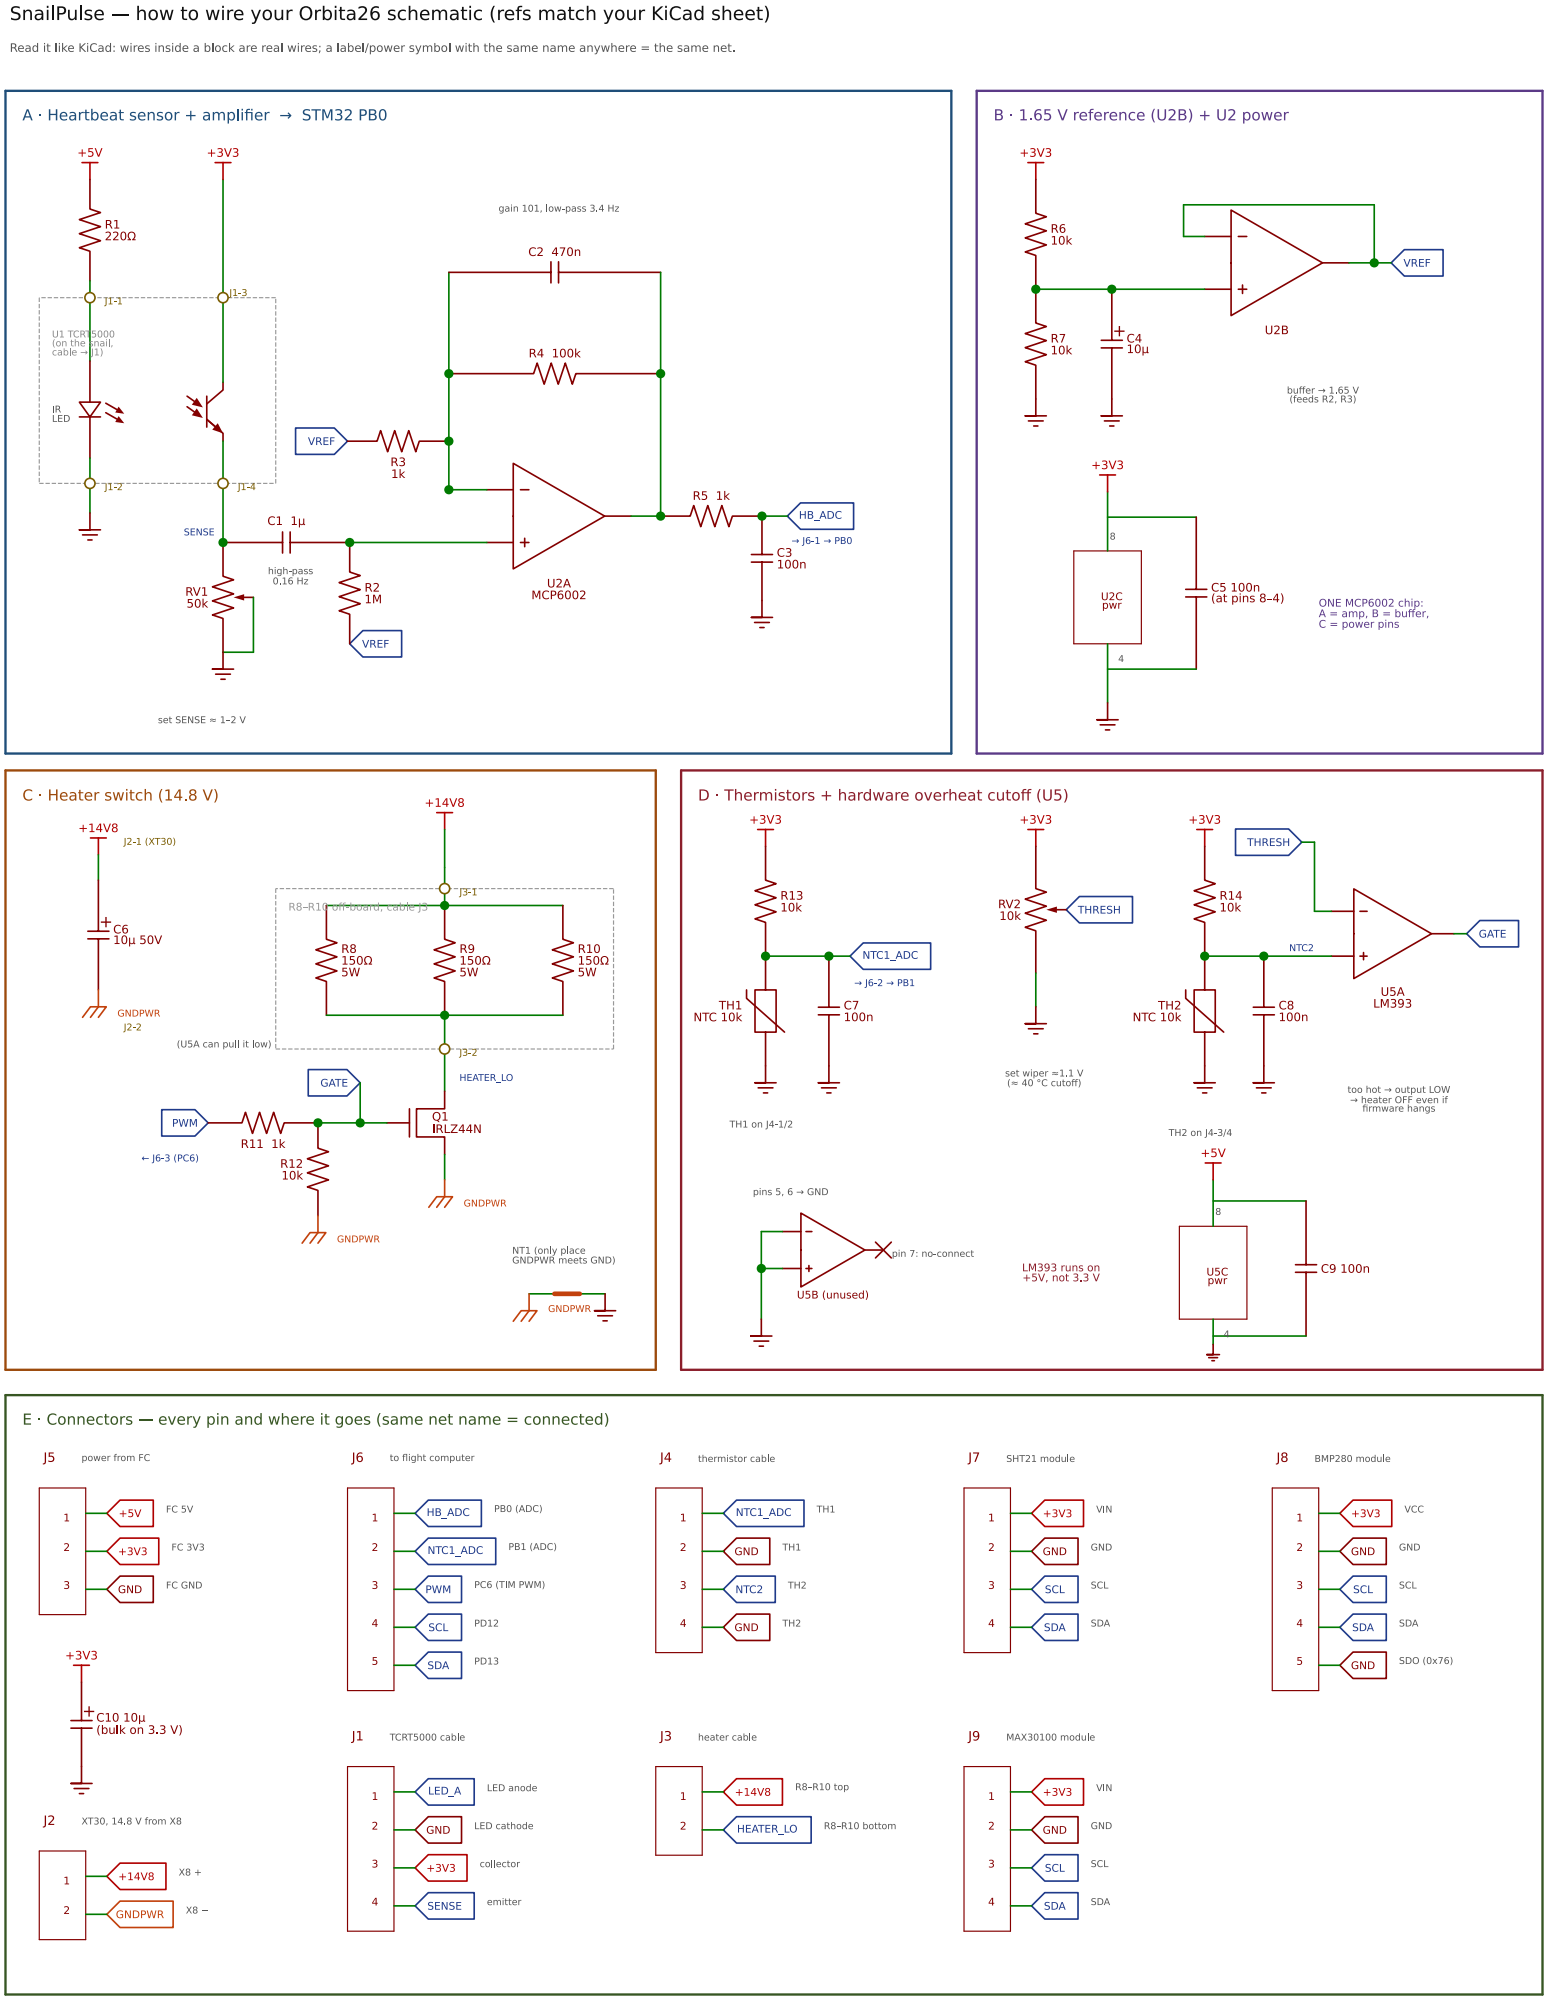
[picture p132: page 1]
