notazizelse/Orbita26/(commit log)

2026-10-22 Schem, readme, firmware done preliminarily
    [Orbita26.kicad_pcb, Orbita26.kicad_sch, SnailPulse_BOM.xlsx, SnailPulse_KiCad_Connections.xlsx]
2026-10-23 Fixed schem problems & improved readme
    [Orbita26.kicad_pcb, Orbita26.kicad_sch]
2026-10-27 added relevant documentation
    [Orbita26.kicad_pcb, Orbita26.kicad_sch, SnailPulse_BOM_v2.xlsx, SnailPulse_BOM_v2_RU.xlsx]
2026-10-29 Add DHT-11, MQ-7 and BMP280 0x77: sensor test sketch, flight fw 1.2, build guides
    - firmware/tools/SensorTest: new bench sketch for the flight controller. PASS/WARN/FAIL
    for every sensor (SHT21, BMP280 0x77/0x76, MAX30100, DHT-11 on PC6, MQ-7 on PB1,
    heartbeat PB0, FC's LSM6DS3/LIS3MDL/LM75A/MS5611) plus cross-checks, live view and
    plotter stream on the FC USB-C. Builds on STM32 core 2.12 and 3.0.
    - SnailPulse_Flight 1.2: rev C no-heater patch applied, DHT-11 driver (non-blocking
    start, bit read right after the 50 Hz ISR), MQ-7 sampled in the ISR, BMP280 at 0x77,
    ENV packet grows 24 -> 30 bytes (DHT T/RH, MQ-7 mV, sensors_ok bits 5/6).
    Compiles for H750VBTx on core 2.12; not yet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
    [HB_Tune.ino, SensorTest.ino, SnailPulse_Flight.ino, config.h, dht11_decode.h, payload_sensors.cpp, payload_sensors.h, protocol.h]
2026-10-29 Support two BMP280s: #1 at 0x76 (SDO->GND), #2 at 0x77 (SDO->VCC)
    The board has two BMP280 modules on I2C4, not one module moved to 0x77.
    - SensorTest: both addresses are required (FAIL if either is missing, with a hint
    when both SDO pins are on the same rail), cross-checks #1 vs #2 and each vs MS5611.
    - Flight fw 1.2: BMP280 #1 at 0x76 (ADDR_BMP280, as on J8) and #2 at 0x77
    (ADDR_BMP280_B), both read and retried. ENV grows to 36 bytes (box2_press_pa,
    bmp2_t_c100), sensors_ok bit 7 = BMP280 #2, so a healthy board reads ok=0xF7.
    - Ground station decodes 36-, 30- and 24-byte ENV, shows both BMP280s and plots
    both box pressures.
    - Perfboard guide: BMP280 #1 back to SDO->GND (step 9), B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
    [SensorTest.ino, SnailPulse_Flight.ino, config.h, payload_sensors.h, protocol.h, snailpulse_ground.py, test_host.cpp]
2026-10-29 Add setup guide (works from Russia), prebuilt firmware, HANDOFF.md, CLAUDE.md
    - docs/Software_Setup.md: macOS and Windows commands to install, flash and test.
    arduino.cc is blocked from Russian IPs and st.com refuses some downloads, so the
    flash-only path uses GitHub/Homebrew only: stlink (st-flash), Zadig on Windows,
    pyserial's miniterm as serial monitor. Building from source pins the STM32 core
    and libraries to GitHub URLs and explains the one-time arduino.cc step.
    - firmware/build_backup: prebuilt SensorTest, HB_Tune and flight fw 1.2 .bin files
    (core 2.12.0, IntroStratLib 0.1.2, STM32SD 1.5.0, FatFs 4.0.4) + SHA256SUMS;
    .gitignore now lets these .bin files in. Old fw 1.0/1.1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
    [Orbita26.kicad_pcb, Orbita26.kicad_sch]
2026-10-29 Add ground monitor, radio handoff, Mac setup script and bench guide
    - ground/snailpulse_monitor.py: browser screen with every sensor's value and
    OK/WARN/FAIL state, cross-checks, charts and the FC's text output. Reads the
    FC's USB-C or the ground LoRa module; --demo and --file replay.
    - Flight fw: every frame also goes out of the FC's USB-C (SP_USB_MIRROR) so the
    bench test needs no radio; STATUS reports FC sensor health (fc_ok, was a
    reserved byte); sp_hooks.h lets the radio technician's code take the frames
    (SP_OWN_RADIO 0); watchdog pauses while a debugger halts the core.
    - radio_handoff/: link contract, four integration routes, C99 header with
    parser and structs (tested again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
    [SnailPulse_Flight.ino, config.h, example_fc_hooks.cpp, ground_receiver.ino, protocol.h, radio.h, snailpulse_frames.h, snailpulse_ground.py]
2026-10-29 Offline Mac install: Arduino bundle builder, setup script uses local files
    - scripts/build_mac_arduino_bundle.py: on any PC outside Russia, builds one
    .tgz with everything Arduino IDE 2.3.10 / arduino-cli 1.5.1 would fetch from
    arduino.cc and GitHub for a Mac (indexes, helper tools, STM32 2.12.0 with
    compiler/OpenOCD, AVR core, libraries). Archive members are copied with their
    Unix modes and symlinks; nothing is unpacked on Windows.
    - scripts/mac_setup.sh: installs the IDE from a local .dmg, unpacks the bundle
    into the home folder, clears the quarantine flag, skips online steps that the
    bundle already covers, works without github.com when given the bundle.
    - docs/Software_Setup.m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
2026-10-29 Keep scripts in Unix line endings; record the first Mac build
    .gitattributes forces LF for *.sh and *.py. On Windows, core.autocrlf
    made git archive zip mac_setup.sh with CRLF, and bash on the Mac
    could not run it.
    HANDOFF.md: mac_setup.sh ran on the team Mac and compiled the 30 Oct
    firmware (SensorTest 57,484 B, flight 83,752 B). It also notes how to
    zip the repo for a Mac and to unpack it with ditto, because macOS
    unzip breaks on the Russian file names.
2026-10-29 Stop the sketches with one clear message when the wrong board is selected
    With another board picked in the Arduino IDE (it was a Daisy board on the
    team Mac), SensorTest failed with dozens of "'PA10' was not declared"
    errors. SensorTest, HB_Tune and the flight firmware now check for
    STM32H750xx, which the STM32 core 2.12.0 defines for "Generic H750VBTx",
    and stop with one line saying which board to pick.
    The header comments now use the exact IDE menu names (Board part number
    "Generic H750VBTx", upload method "OpenOCD STLink (SWD)"), because
    STM32CubeProgrammer is not installed on the Mac.
    [HB_Tune.ino, SensorTest.ino, SnailPulse_Flight.ino]
2026-10-30 Two snails (TCRT5000 + MAX30100), drop the second BMP280 (fw 1.3)
    Snail 1 keeps the TCRT5000 -> amplifier -> PB0 chain. Snail 2 now gets
    its own heart rate from the MAX30100: its FIFO is drained every 40 ms
    (max30100_fifo.h) and OpticalPulse (1 s software high-pass, contact,
    jump and saturation checks) feeds a second HeartbeatDetector. The
    detector takes its thresholds as constructor arguments and can restart.
    The SNAIL payload grows 39 -> 49 bytes (fields appended, old frames still
    decode). The second BMP280 is not used any more: its ENV fields stay but
    are always empty, so a healthy board reports ok=0x77.
    Ground decoder, monitor, radio handoff header/README (new test frames),
    SensorTest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
2026-10-30 DHT-11 and MQ-7 on 5 V (fw 1.4)
    Both modules now run from +5V_IS.
    DHT-11: its pull-up holds DATA at 5 V. PC6 is 5 V-tolerant as a digital
    input, but its internal pull-up goes to 3.3 V and would fight the
    module's, so PC6 now idles as a plain input (DHT11_VCC_5V in config.h,
    DHT_VCC_5V in SensorTest). The line is still only ever driven LOW.
    MQ-7: AO can reach 5 V and PB1 is not 5 V-tolerant in analog mode, so
    AO goes through a 10k/20k divider (R20, R21 on the perfboard). The
    firmware scales the reading back (mq7_scale.h, unit-tested), so ENV
    mq7_mv is the voltage at the module (0-5000 mV); "ok" is still judged at
    PB1. config.h refuses to build a 5 V setup without a divider. SensorTest
    repor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
2026-10-30 Ignore the GY-21 (SHT21): box air from BMP280 + DHT-11 (fw 1.5); add MAX30100_Pulse
    The GY-21 was removed on 30 Oct (it held the I2C4 clock line low).
    Its data is covered by the other sensors: box temperature from the
    BMP280, humidity from the DHT-11.
    Firmware 1.5:
    - config.h: SP_HAS_SHT21 0. The SHT21 is never started or polled, so
    ENV sends box_t/box_rh as invalid (-32768 / 0xFFFF) and sensors_ok
    bit 0 stays clear. A healthy board now reads 0x76.
    - SensorTest: HAVE_SHT21 0 shows the SHT21 as "not fitted" and adds a
    DHT-11 vs BMP280 temperature cross-check.
    - Ground decoder and monitor: skip the SHT21 when its values are
    invalid, plot the BMP280 box temperature, show a "Box air" ro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
    [MAX30100_Pulse.ino, SensorTest.ino, SnailPulse_Flight.ino, config.h, protocol.h, snailpulse_frames.h, snailpulse_ground.py, snailpulse_monitor.py]
2026-10-30 Radio technician test kit; HANDOFF revised; test frames at fw 1.5
    The radio technician had the link contract and parser but no way to test
    one hop of the FC <-> comm board link without the other. Added:
    - radio_handoff/fc_sketches/LinkTest_FC: sends SnailPulse test frames to
    the comm board with the flight ACK rule (0x06, 1.5 s, 8-frame queue) and
    reports ACKs, ACK time and throughput on the FC USB-C.
    - radio_handoff/fc_sketches/CommBridge_FC: USB-C <-> UART1 bridge to type
    commands to the comm board and see its replies (ACK shows as <06>).
    - radio_handoff/tools/sp_link_tool.py: with a USB-UART adapter, plays the
    comm board (fake-comm) or the FC (fake-fc); selftest needs no hardware.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
2026-10-30 Radio README: zip command for the full radio kit
    The old command packed only the flight sketch, so the test sketches, PC
    tests and IntroSat guides were missing, and it had a stray "\n" that broke
    it. The new one packs this folder, ground/, all of firmware/, scripts/, the
    setup docs and both IntroSat.Platform guides, without git history or team
    files. Adds the Mac unpack note (ditto) for the Russian file name.
